Trap-1/HOMIE-Teleop-Hardware/README.md

# <center> HOMIE: Humanoid Loco-Manipulation with Isomorphic Exoskeleton Cockpit</center>
