Trap-1/HOMIE-Teleop-Hardware/Geber &  Boom/BOM_Gloves.csv

ID | Name | Designator | Footprint | Quantity | Manufacturer Part | Supplier Part | Price | Pins | 3DModel | link
1 | 104 | C8,C15,C16,C1,C2,C3,C4,C6,C7 | C0603 | 9 |  |  |  | 2 | C0603_L1.6-W0.8-H0.8 | https://item.szlcsc.com/362304.html
2 | 106 | C9,C5 | C0603 | 2 |  |  |  | 2 | C0603_L1.6-W0.8-H0.8 | https://item.szlcsc.com/362304.html
3 | 1k | R2,R5,R18 | R0603 | 3 |  |  |  | 2 | R0603 | https://www.mouser.in/datasheet/2/447/PYu_RT_1_to_0_01_RoHS_L_11-1669912.pdf
4 | AMS1117-3.3V | U2 | SOT-223-4_L6.5-W3.5-P2.30-LS7.0-BR | 1 | AMS1117-3.3V | C2688239 | 0.397 | 4 | SOT-223-4P_L6.5-W3.5-H1.6-LS7.0-P2.30 | https://item.szlcsc.com/84517.html
5 | 47UF/10V | U4 | C1206 | 1 | 47uF/10V | C9900008467 |  | 2 | C1206_L3.2-W1.6-H1.3 | https://atta.szlcsc.comnull
6 | XH-4AW_C2908613 | CN2 | CONN-TH_XH-4AW | 1 | XH-4AW | C2908613 | 0.1565 | 4 | CONN-TH_XH-4AW | https://atta.szlcsc.com/upload/public/pdf/source/20211021/ACA2D54D99493880102FCACAC8DAABA8.pdf
7 | LED0603-R | LED1,LED2,LED9 | LED0603-R-RD | 3 | LED0603-R | C9900005326 |  | 2 | LED0603-R-RD | https://lcsc.com/product-detail/Light-Emitting-Diodes-LED_Hubei-KENTO-Elec-0603-Green_C12624.html
8 | 10k | R1,R11,R15 | R0603 | 3 |  |  |  | 2 | R0603 | https://www.mouser.in/datasheet/2/447/PYu_RT_1_to_0_01_RoHS_L_11-1669912.pdf
9 | STM32F103C8T6 | U1 | LQFP-48_L7.0-W7.0-P0.50-LS9.0-BL | 1 | STM32F103C8T6 | C8734 | 7.45 | 48 | LQFP-48_L7.0-W7.0-H1.4-LS9.0-P0.50 | https://atta.szlcsc.com/upload/public/pdf/source/20190808/C411336_D1D2DF7683029D856BA010BA7A5BF7EA.pdf
10 | CD74HC4067SM96 | U3 | SSOP-24_L8.1-W5.3-P0.65-LS7.8-BL | 1 | CD74HC4067SM96 | C98457 | 3.4 | 24 | SSOP-24_L8.2-W5.3-H1.8-LS7.8-P0.65 | https://item.szlcsc.com/255758.html
11 | WAFER-PH2.0-3PZZ-R62 | U5,U6,U8,U10,U11,U12,U13,U14,U15,U16,U17,U18,U19,U20,U21 | CONN-TH_4P-P2.00_WAFER-PH2.0-3PZZ-R62 | 15 | WAFER-PH2.0-3PZZ-R62 | C22390428 | 0.1784 | 3 | CONN-TH_3P-P2.00_WAFER-PH2.0-3PZZ-R62 | https://atta.szlcsc.com/upload/public/pdf/source/20240428/DCE8F361ED40A64D6B78F768F58AF30D.pdf
12 | CH340E | U7 | MSOP-10_L3.0-W3.0-P0.50-LS5.0-BL | 1 | CH340E | C99652 | 4.19 | 10 | MSOP-10_L3.0-W3.0-H1.1-LS5.0-P0.50 | https://item.szlcsc.com/221388.html
13 | TPS645-5NC60 | U9,U22 | SW-SMD_4P-L6.0-W6.0-P4.50-LS9.2 | 2 | TPS645-5NC60 | C19191552 | 0.2853 | 4 | SW-SMD_4P-L6.0-W6.0-P4.50-LS9.2 | https://item.szlcsc.com/617126.html
14 | UX-150-ARG4 | USB1 | MICRO-USB-TH_UX-150-ARG4 | 1 | UX-150-ARG4 | C720612 | 0.6217 | 9 | MICRO-USB-TH_UX-150-ARG4 | https://item.szlcsc.com/763619.html
15 | 8MHz | X1 | OSC-SMD_3P-L3.2-W1.3-P1.2-L | 1 | CSTCE8M00G52-R0 | C22549 | 1.4275 | 3 | OSC-SMD_3P-L3.2-W1.3-H0.8-P1.2 | https://item.szlcsc.com/23275.html
