Trap-1/HOMIE-Teleop-Hardware/Geber &  Boom/BOM_Pedal.csv

ID | Name | Designator | Footprint | Quantity | Manufacturer Part | Supplier Part | Price | Pins | 3DModel | link
1 | ZX-XH2.54-2PZZ | CN7,CN8,CN1 | CONN-TH_2P-P2.50_HX25003-2A | 3 | ZX-XH2.54-2PZZ | C7429632 | 0.0377 | 2 | CONN-TH_2P-P2.50_HX25003-2A | https://item.szlcsc.com/442531.html
2 | 104 | C2,C3,C16,C1,C4,C7,C8,C11,C15 | C0603 | 9 |  |  |  | 2 | C0603_L1.6-W0.8-H0.8 | https://item.szlcsc.com/362304.html
3 | 10k | R15,R17,R19,R20,R16,R11 | R0603 | 6 |  |  |  | 2 | R0603 | https://www.mouser.in/datasheet/2/447/PYu_RT_1_to_0_01_RoHS_L_11-1669912.pdf
4 | XH-4AW_C2908613 | CN2 | CONN-TH_XH-4AW | 1 | XH-4AW | C2908613 | 0.1565 | 4 | CONN-TH_XH-4AW | https://atta.szlcsc.com/upload/public/pdf/source/20211021/ACA2D54D99493880102FCACAC8DAABA8.pdf
5 | XH-3AW_C2908612 | CN3,CN4,CN5,CN6 | CONN-TH_3P-P2.54_HCTL_XH-3AW | 4 | XH-3AW | C2908612 | 0.1187 | 3 | CONN-TH_3P-P2.54_HCTL_XH-3AW | https://atta.szlcsc.com/upload/public/pdf/source/20211021/ACA2D54D99493880102FCACAC8DAABA8.pdf
6 | OLED | HDR1 | HDR-TH_4P-P2.54-V-M | 1 |  | C9900026893 |  | 4 | HDR-TH_4P-P2.54-M-LI-1X4P | https://item.szlcsc.com/502959.html
7 | Header-Male-2.54_2x3 | J1 | HDR-TH_6P-P2.54-V-M-R2-C3-S2.54-1 | 1 | 2.54-2*3P针 | C65114 | 0.1969 | 6 | HDR2.54-M-LI-2x3P | https://lcsc.com/product-detail/Female-Header_Made-in-China-Made-in-China-Made-in-China-Made-in-Cina-2-54mm-2x3-Female-header-Bagged-RoHS_C47552.html
8 | LED0603-R | LED1,LED2,LED9 | LED0603-R-RD | 3 | LED0603-R | C9900005326 |  | 2 | LED0603-R-RD | https://lcsc.com/product-detail/Light-Emitting-Diodes-LED_Hubei-KENTO-Elec-0603-Green_C12624.html
9 | 2N3904_C2874602 | Q1 | TO-92-3_L4.6-W3.6-P1.30-L_2N3904 | 1 | 2N3904 | C2874602 | 0.0733 | 3 | TO-92-3_L4.6-W3.6-P1.30-L_2N3904 | https://atta.szlcsc.com/upload/public/pdf/source/20211216/4B1D0208BBB09785024BED84C152EFE5.pdf
10 | 1k | R2,R5,R18 | R0603 | 3 |  |  |  | 2 | R0603 | https://www.mouser.in/datasheet/2/447/PYu_RT_1_to_0_01_RoHS_L_11-1669912.pdf
11 | STM32F103C8T6 | U1 | LQFP-48_L7.0-W7.0-P0.50-LS9.0-BL | 1 | STM32F103C8T6 | C8734 | 7.45 | 48 | LQFP-48_L7.0-W7.0-H1.4-LS9.0-P0.50 | https://atta.szlcsc.com/upload/public/pdf/source/20190808/C411336_D1D2DF7683029D856BA010BA7A5BF7EA.pdf
12 | CH340E | U7 | MSOP-10_L3.0-W3.0-P0.50-LS5.0-BL | 1 | CH340E | C99652 | 4.19 | 10 | MSOP-10_L3.0-W3.0-H1.1-LS5.0-P0.50 | https://item.szlcsc.com/221388.html
13 | TPS645-5NC60 | U9,U10 | SW-SMD_4P-L6.0-W6.0-P4.50-LS9.2 | 2 | TPS645-5NC60 | C19191552 | 0.2853 | 4 | SW-SMD_4P-L6.0-W6.0-P4.50-LS9.2 | https://item.szlcsc.com/617126.html
14 | UX-150-ARG4 | USB1 | MICRO-USB-TH_UX-150-ARG4 | 1 | UX-150-ARG4 | C720612 | 0.6217 | 9 | MICRO-USB-TH_UX-150-ARG4 | https://item.szlcsc.com/763619.html
15 | 8MHz | X1 | OSC-SMD_3P-L3.2-W1.3-P1.2-L | 1 | CSTCE8M00G52-R0 | C22549 | 1.4275 | 3 | OSC-SMD_3P-L3.2-W1.3-H0.8-P1.2 | https://item.szlcsc.com/23275.html
16 | 106 | C5,C9 | C0603 | 2 |  |  |  | 2 | C0603_L1.6-W0.8-H0.8 | https://item.szlcsc.com/362304.html
17 | AMS1117-3.3V | U2 | SOT-223-4_L6.5-W3.5-P2.30-LS7.0-BR | 1 | AMS1117-3.3V | C2688239 | 0.397 | 4 | SOT-223-4P_L6.5-W3.5-H1.6-LS7.0-P2.30 | https://item.szlcsc.com/84517.html
18 | 47UF/10V | U4 | C1206 | 1 | 47uF/10V | C9900008467 |  | 2 | C1206_L3.2-W1.6-H1.3 | https://atta.szlcsc.comnull
