Trap-1/HOMIE-Teleop-Hardware/Geber &  Boom/BOM_Hall-sensor.csv

ID | Name | Designator | Footprint | Quantity | Manufacturer Part | Supplier Part | Price | Pins | 3DModel | link
1 | WAFER-PH2.0-3PZZ-R62 | U3 | CONN-TH_4P-P2.00_WAFER-PH2.0-3PZZ-R62 | 1 | WAFER-PH2.0-3PZZ-R62 | C22390428 | 0.1784 | 3 | CONN-TH_3P-P2.00_WAFER-PH2.0-3PZZ-R62 | https://atta.szlcsc.com/upload/public/pdf/source/20240428/DCE8F361ED40A64D6B78F768F58AF30D.pdf
2 | MS49E | U1 | TO-92S-3_L4.1-W1.7-P1.27-L | 1 | MS49E | C1509062 | 3 | 3 | TO-92S-3_L4.1-W1.7-H6.5-P1.27-L | https://item.szlcsc.com/product/jpg_256473_0.html
