Trap-1/HOMIE-Teleop-Hardware/3D printed models/Foot Pedal/Switch pedal/Whole switch pedal.step

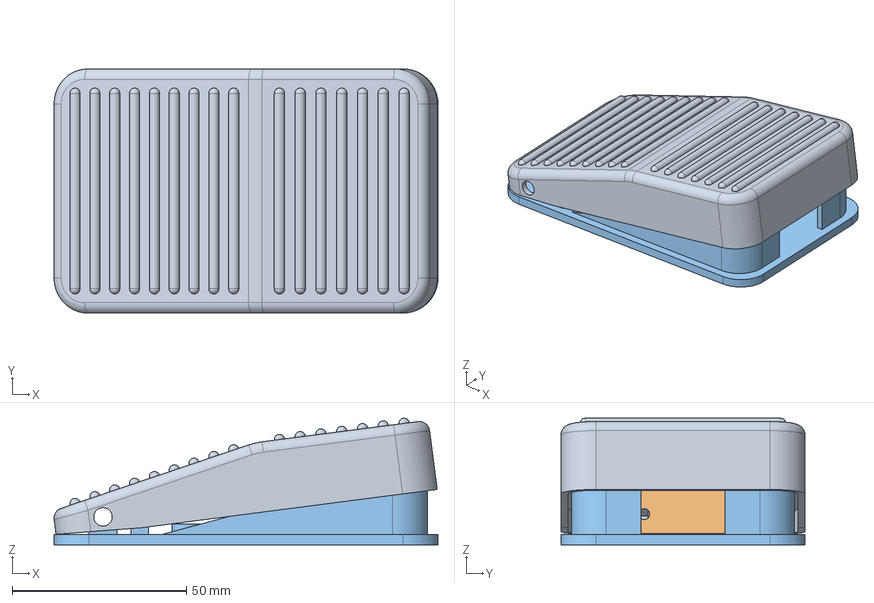
[picture p1: CAD file, 2025-02-11]
3D printed models/Foot Pedal/Switch pedal/Whole switch pedal.step
110.0 x 70.0 x 36.3 mm
上板
连接件2
底板
