Trap-1/HOMIE-Teleop-Hardware/3D printed models/Foot Pedal/Small pedal/Whole small pedal.step

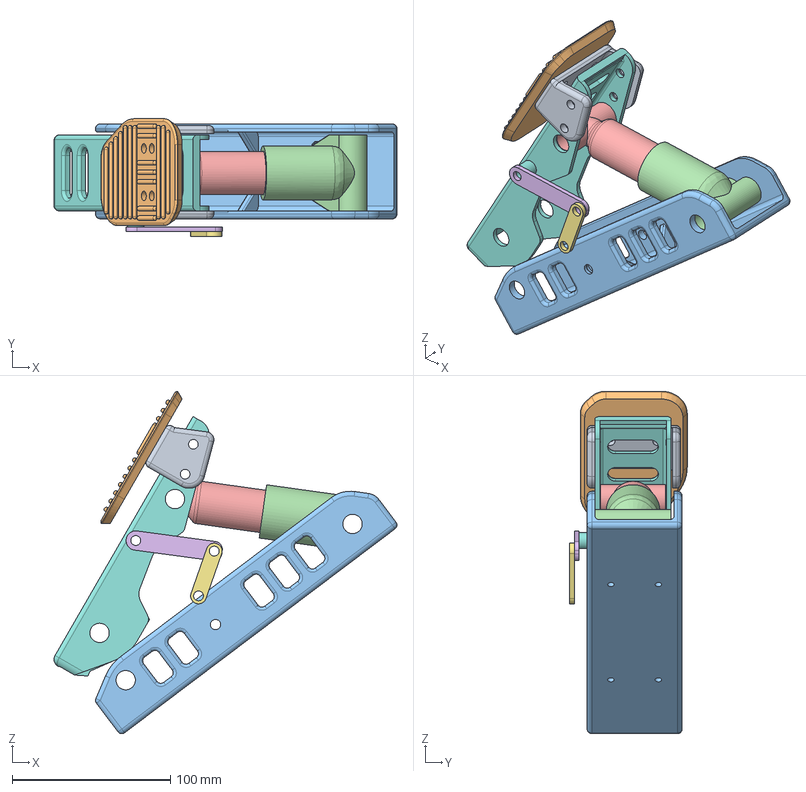
[picture p2: CAD file, 2025-02-11]
3D printed models/Foot Pedal/Small pedal/Whole small pedal.step
216.7 x 74.3 x 216.4 mm
零部件2
零部件3
零部件4
零部件5
零部件6
零部件7
零部件8
零部件9
