Trap-1/HOMIE-Teleop-Hardware/3D printed models/Exoskeleton/Fourier_GR-1/ARM_LEFT/ARM_6.step

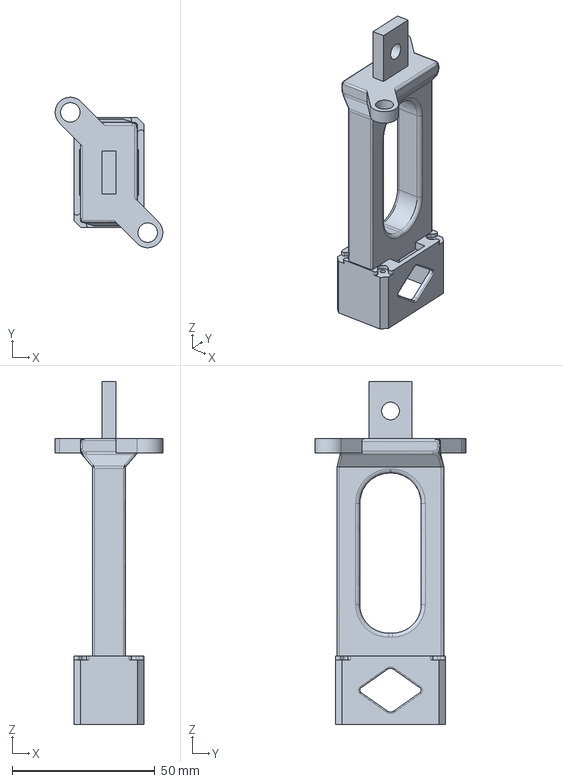
[picture p3: CAD file, 2025-02-11]
3D printed models/Exoskeleton/Fourier_GR-1/ARM_LEFT/ARM_6.step
37.7 x 52.7 x 120.0 mm
