Trap-1/HOMIE-Teleop-Hardware/3D printed models/Exoskeleton/Fourier_GR-1/ARM_RIGHT/ARM_2.step

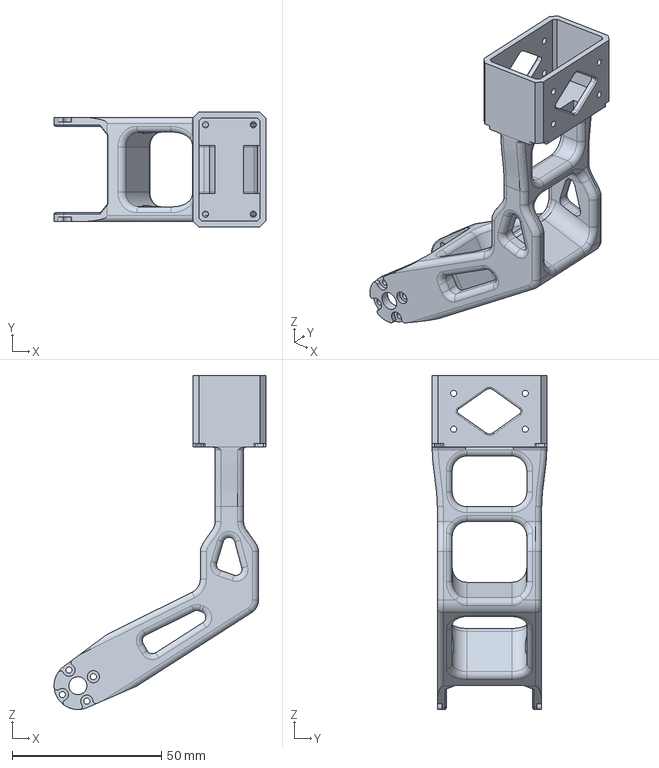
[picture p4: CAD file, 2025-02-11]
3D printed models/Exoskeleton/Fourier_GR-1/ARM_RIGHT/ARM_2.step
71.0 x 38.5 x 112.0 mm
