Trap-1/HOMIE-Teleop-Hardware/3D printed models/Exoskeleton/Fourier_GR-1/BACK/BACK-5(RIGHT).step

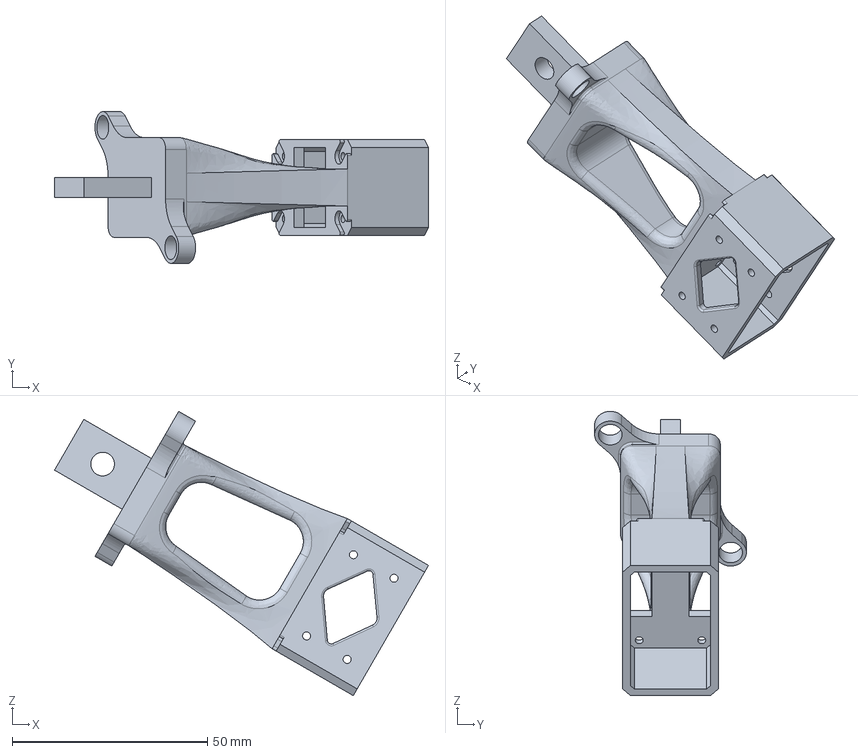
[picture p5: CAD file, 2025-02-11]
3D printed models/Exoskeleton/Fourier_GR-1/BACK/BACK-5(RIGHT).step
95.7 x 38.9 x 72.8 mm
