Trap-1/HOMIE-Teleop-Hardware/3D printed models/Exoskeleton/Fourier_GR-1/WRIST_LINK/WRIST_LINK_RIGHT.step

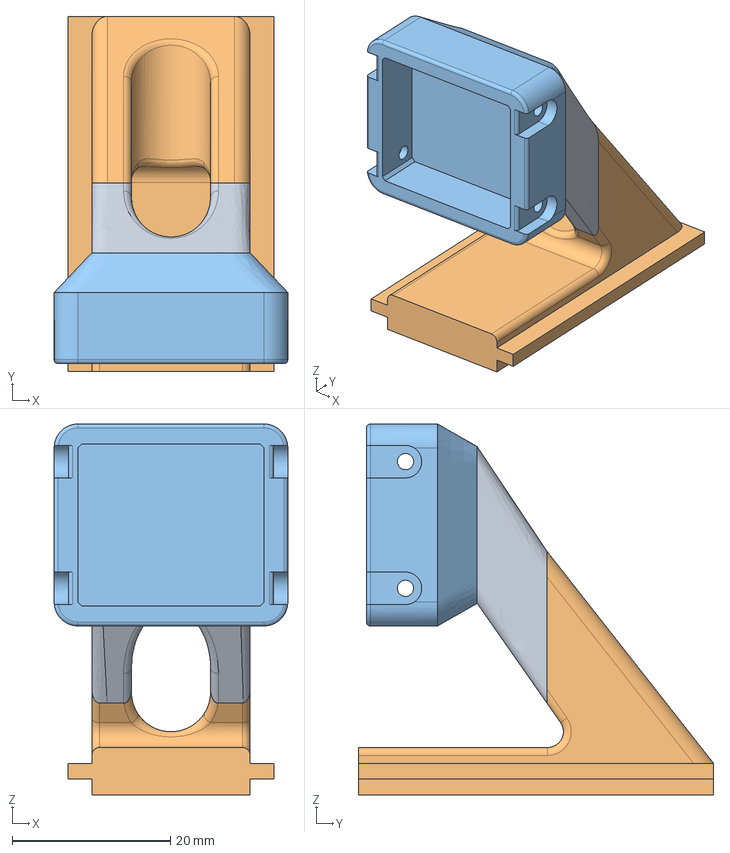
[picture p6: CAD file, 2025-02-11]
3D printed models/Exoskeleton/Fourier_GR-1/WRIST_LINK/WRIST_LINK_RIGHT.step
29.5 x 44.9 x 46.8 mm
手部连接2 (2)(镜像)(镜像)
手部连接1(镜像)(镜像)
外骨骼_基础2 v1 (1)(镜像)
