Trap-1/HOMIE-Teleop-Hardware/3D printed models/Exoskeleton/Unitree_G1/ARM_LEFT/ARM_5.step

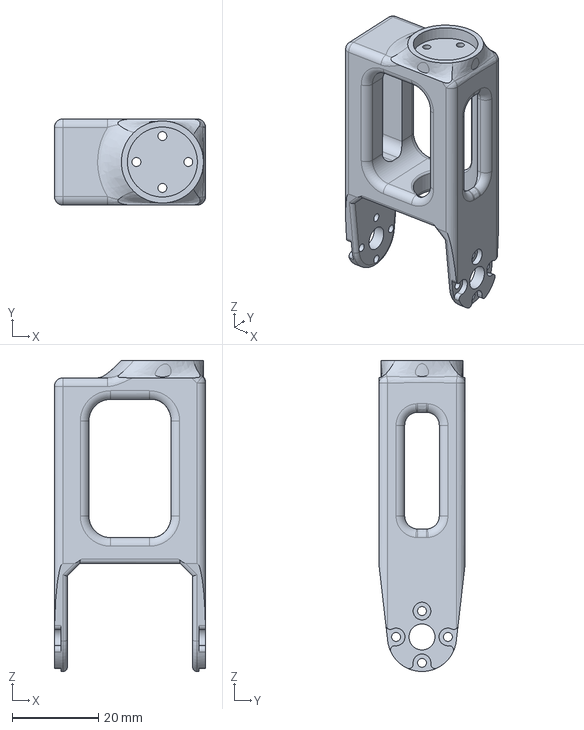
[picture p7: CAD file, 2025-02-11]
3D printed models/Exoskeleton/Unitree_G1/ARM_LEFT/ARM_5.step
35.0 x 20.0 x 72.0 mm
