Trap-1/HOMIE-Teleop-Hardware/3D printed models/Exoskeleton/Unitree_G1/BACK/BACK_3.step

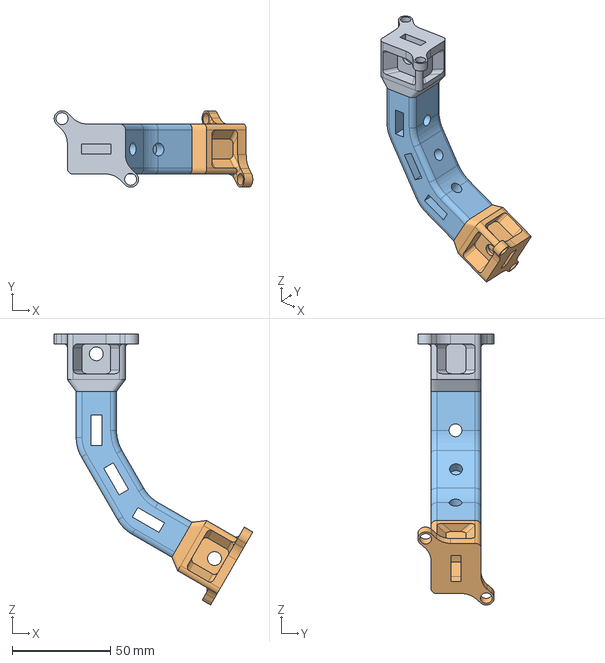
[picture p8: CAD file, 2025-02-11]
3D printed models/Exoskeleton/Unitree_G1/BACK/BACK_3.step
100.9 x 38.9 x 137.7 mm
