Trap-1/HOMIE-Teleop-Hardware/3D printed models/Exoskeleton/Unitree_G1/WRIST_LINK/WRIST_LINK_LEFT.step

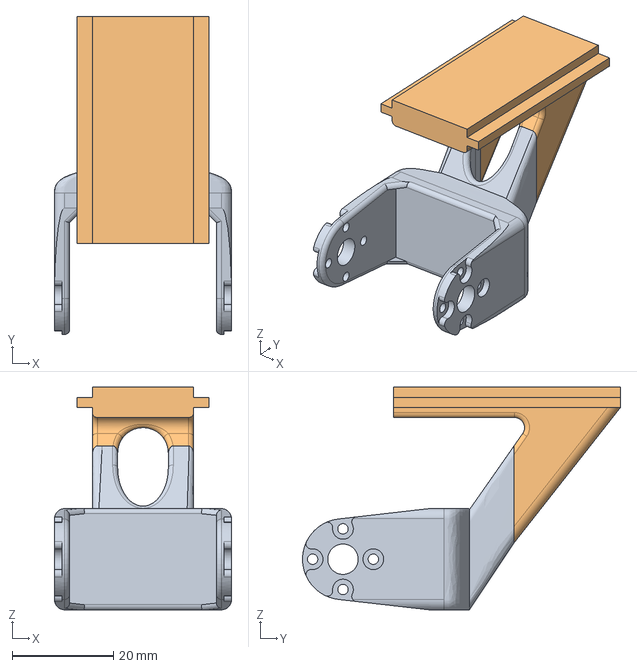
[picture p9: CAD file, 2025-02-11]
3D printed models/Exoskeleton/Unitree_G1/WRIST_LINK/WRIST_LINK_LEFT.step
35.0 x 62.9 x 44.0 mm
手部连接2 (2)(镜像)
手部连接1(镜像)
