Trap-1/HOMIE-Teleop-Hardware/3D printed models/Foot Pedal/Base plate/Baseplate.step

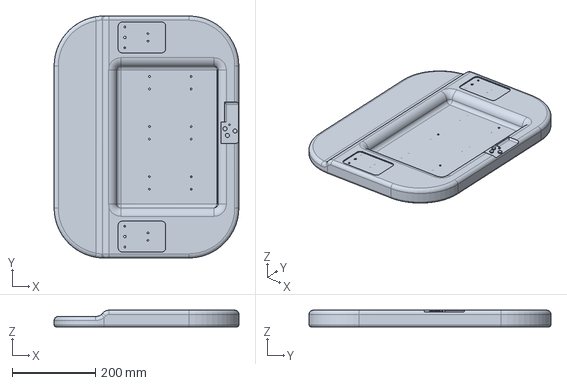
[picture p10: CAD file, 2025-02-11]
3D printed models/Foot Pedal/Base plate/Baseplate.step
443.0 x 580.0 x 40.0 mm
