Trap-1/HOMIE-Teleop-Hardware/3D printed models/Gloves/Left glove/1 Thumb/Thumb_4(special).step

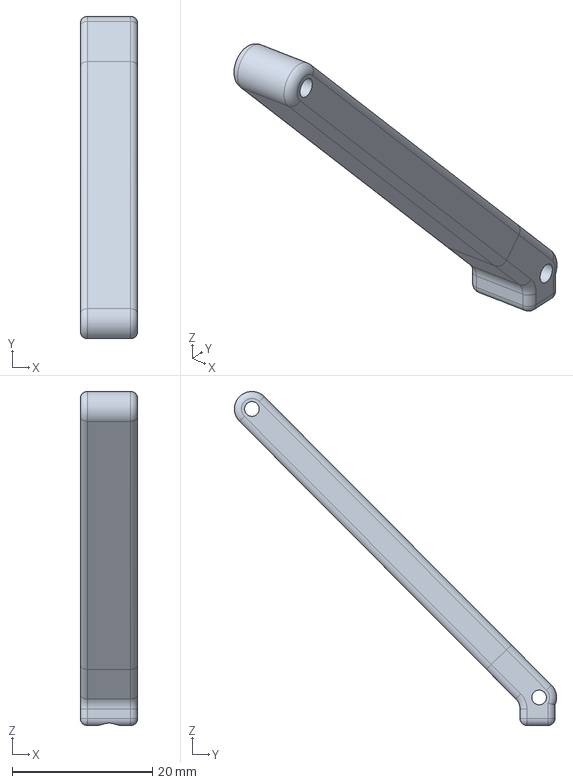
[picture p12: CAD file, 2025-02-11]
3D printed models/Gloves/Left glove/1 Thumb/Thumb_4(special).step
8.21 x 46.0 x 47.7 mm
