Trap-1/HOMIE-Teleop-Hardware/3D printed models/Gloves/Left glove/2 Index finger/Index finger_6.step

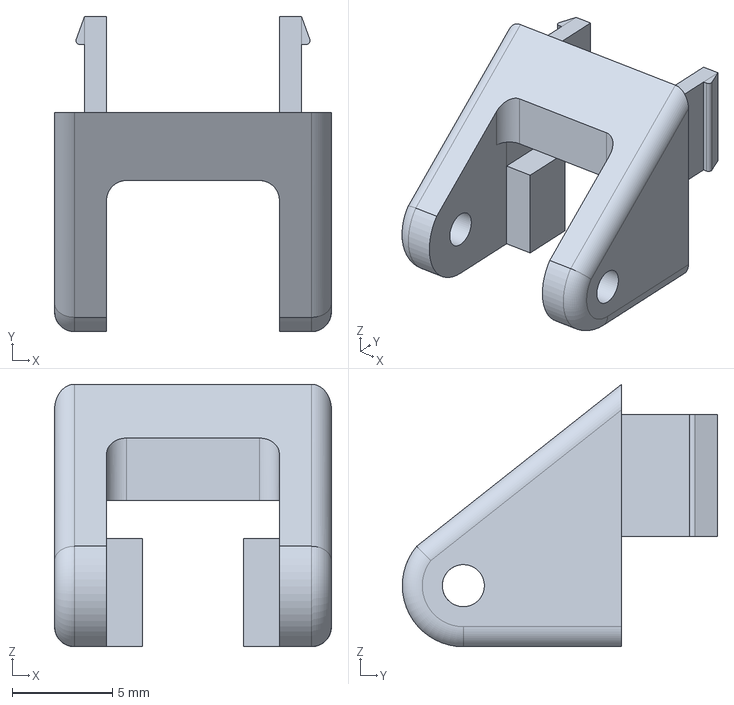
[picture p13: CAD file, 2025-02-11]
3D printed models/Gloves/Left glove/2 Index finger/Index finger_6.step
13.8 x 15.8 x 13.1 mm
