Trap-1/HOMIE-Teleop-Hardware/3D printed models/Gloves/Left glove/3 Middle finger/Middle finger_7.step

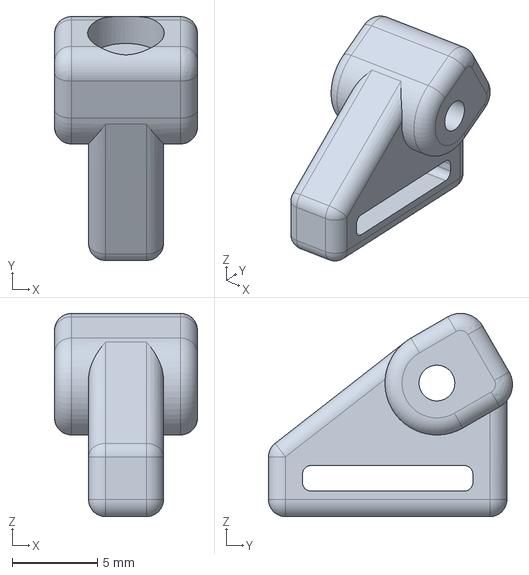
[picture p14: CAD file, 2025-02-11]
3D printed models/Gloves/Left glove/3 Middle finger/Middle finger_7.step
8.40 x 14.3 x 11.9 mm
