Trap-1/HOMIE-Teleop-Hardware/3D printed models/Gloves/Left glove/4 Ring finger/Ring finger_4.step

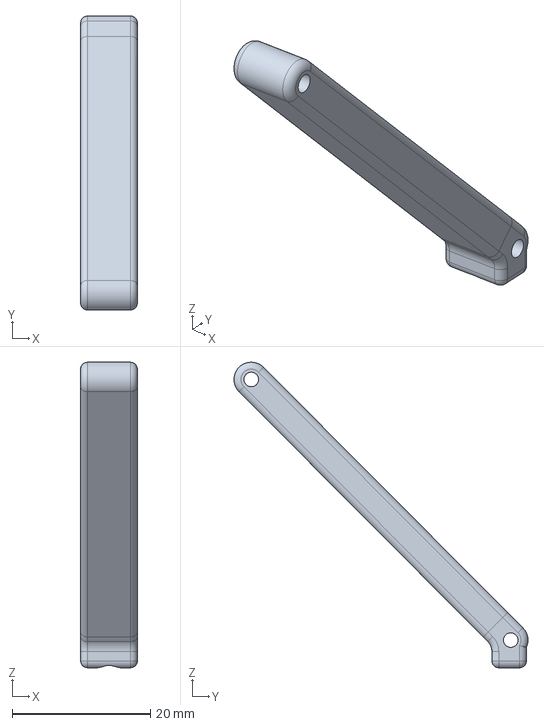
[picture p15: CAD file, 2025-02-11]
3D printed models/Gloves/Left glove/4 Ring finger/Ring finger_4.step
8.21 x 42.5 x 44.2 mm
