Trap-1/HOMIE-Teleop-Hardware/3D printed models/Gloves/Left glove/6 Palm/Palm_2.step

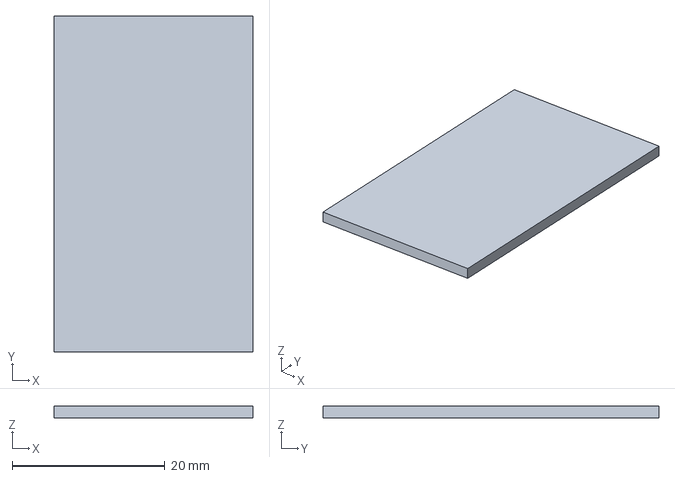
[picture p16: CAD file, 2025-02-11]
3D printed models/Gloves/Left glove/6 Palm/Palm_2.step
26.0 x 44.0 x 1.60 mm
