Trap-1/HOMIE-Teleop-Hardware/3D printed models/Gloves/Right glove/2 Index finger/Index finger_2.step

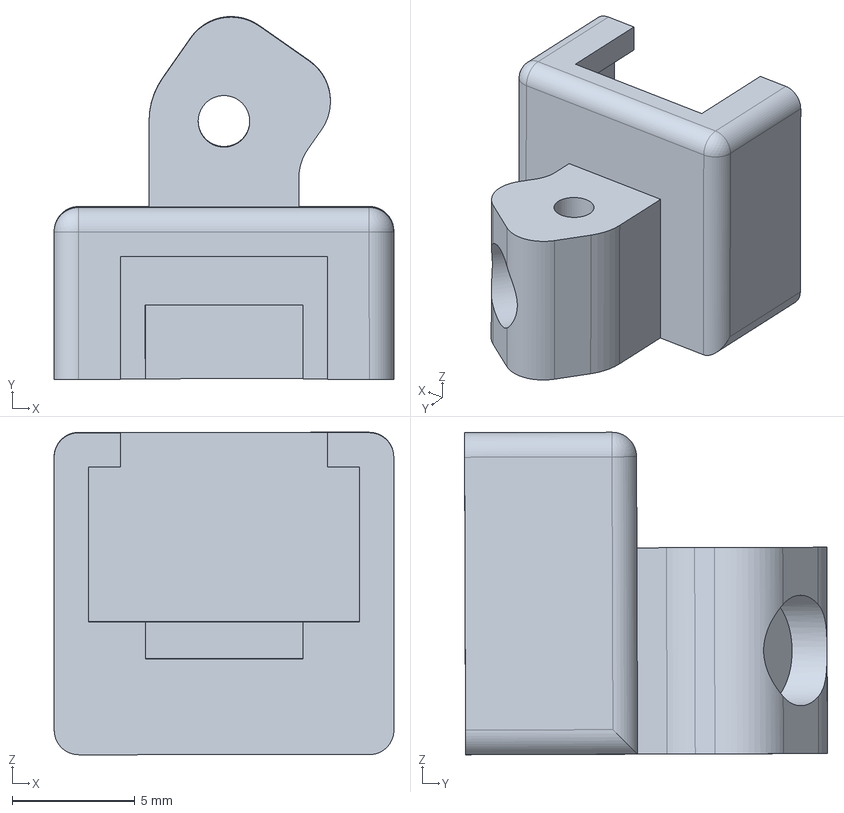
[picture p17: CAD file, 2025-02-11]
3D printed models/Gloves/Right glove/2 Index finger/Index finger_2.step
13.8 x 14.8 x 13.1 mm
