Trap-1/HOMIE-Teleop-Hardware/3D printed models/Gloves/Right glove/3 Middle finger/Middle finger_5.step

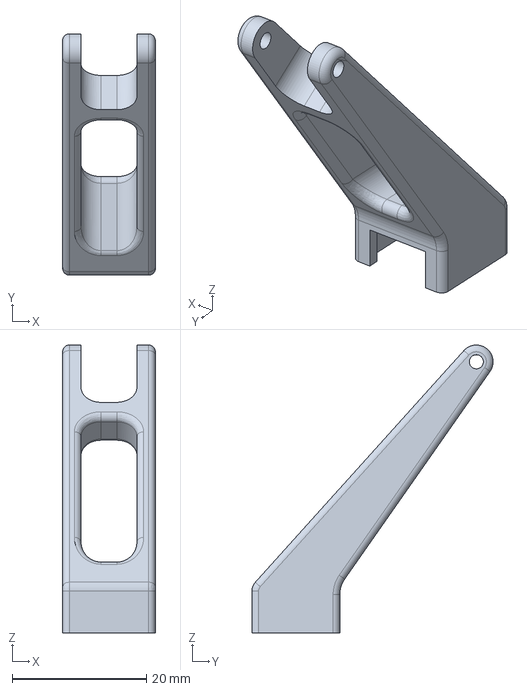
[picture p18: CAD file, 2025-02-11]
3D printed models/Gloves/Right glove/3 Middle finger/Middle finger_5.step
13.8 x 36.0 x 42.9 mm
