Trap-1/HOMIE-Teleop-Hardware/3D printed models/Gloves/Right glove/6 Palm/Palm_1.step

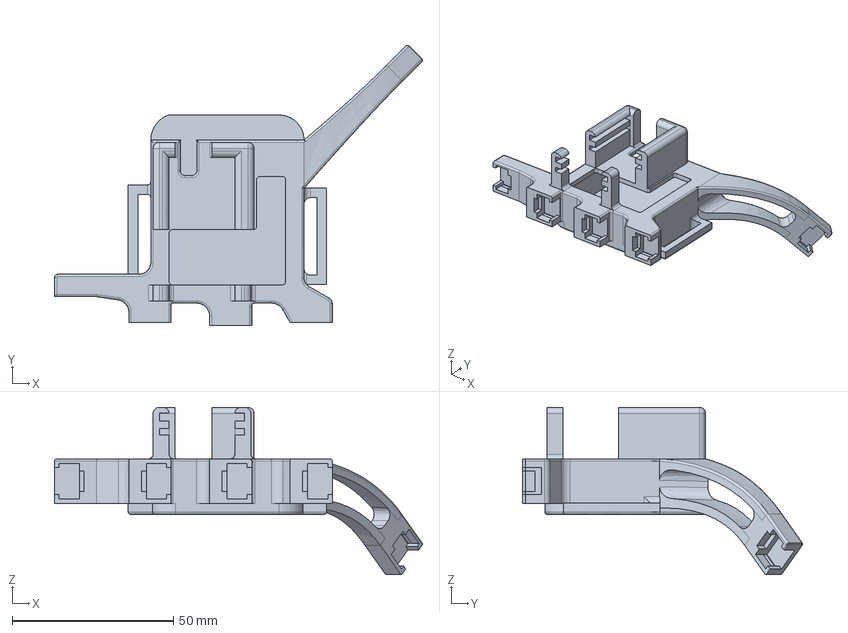
[picture p19: CAD file, 2025-02-11]
3D printed models/Gloves/Right glove/6 Palm/Palm_1.step
114.2 x 87.0 x 52.0 mm
