Trap-1/HOMIE-Teleop-Hardware/3D printed models/Imitation Learning/Head_camera_D455/Head_camera_D455.step

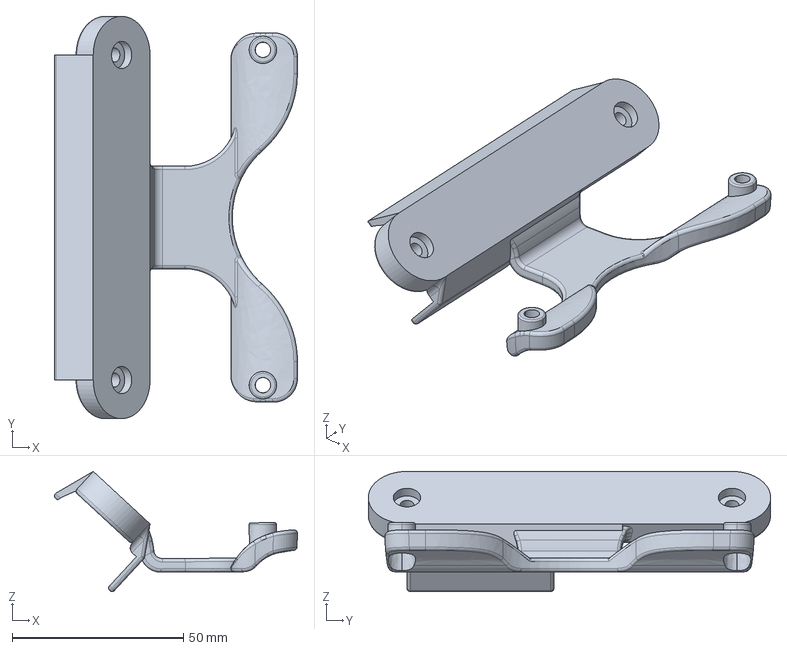
[picture p20: CAD file, 2025-02-12]
3D printed models/Imitation Learning/Head_camera_D455/Head_camera_D455.step
71.0 x 117.6 x 35.1 mm
