Trap-1/HOMIE-Teleop-Hardware/3D printed models/Imitation Learning/Wrist_camera_D435/Right_Wrist_camera_D435.step

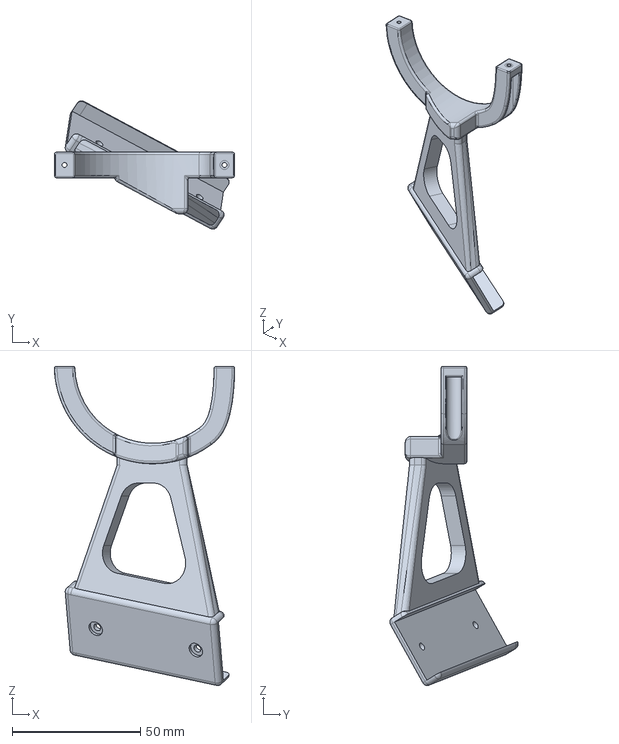
[picture p21: CAD file, 2025-02-12]
3D printed models/Imitation Learning/Wrist_camera_D435/Right_Wrist_camera_D435.step
70.2 x 50.0 x 124.2 mm
