Trap-1/HOMIE-Teleop-Hardware/3D printed models/Exoskeleton/Fourier_GR-1/ARM_RIGHT/ARM_8.step

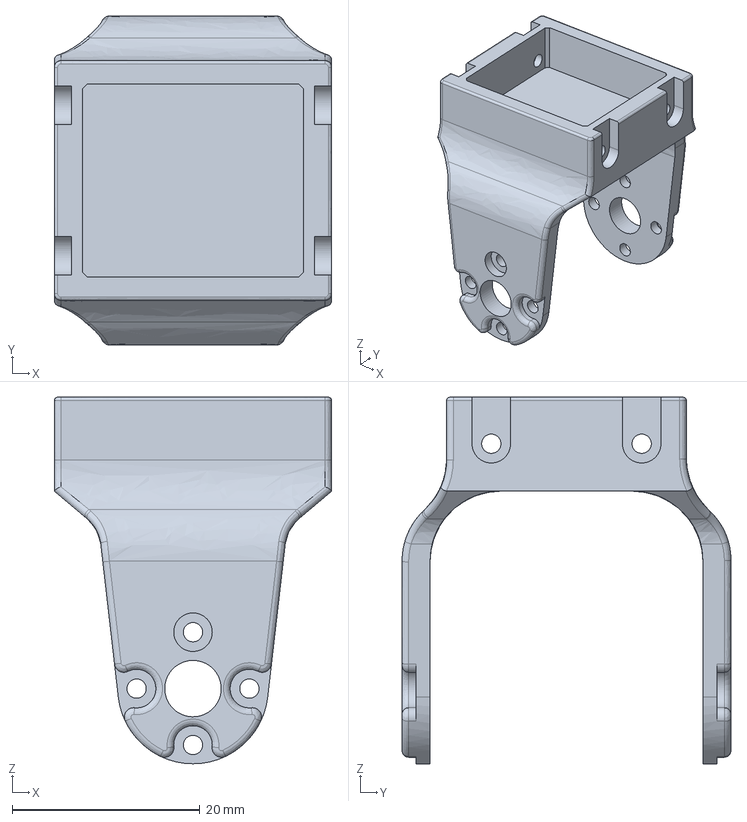
[picture p23: CAD file, 2025-02-11]
3D printed models/Exoskeleton/Fourier_GR-1/ARM_RIGHT/ARM_8.step
29.5 x 35.0 x 39.0 mm
