Trap-1/HOMIE-Teleop-Hardware/3D printed models/Exoskeleton/Fourier_GR-1/BACK/BACK_2.step

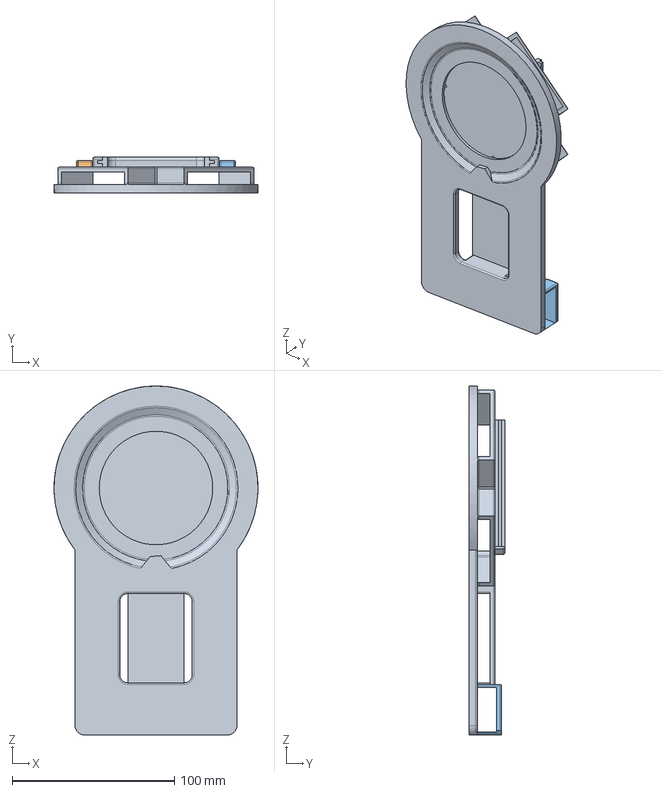
[picture p24: CAD file, 2025-02-11]
3D printed models/Exoskeleton/Fourier_GR-1/BACK/BACK_2.step
125.7 x 22.0 x 215.2 mm
