Trap-1/HOMIE-Teleop-Hardware/3D printed models/Exoskeleton/Unitree_G1/ARM_LEFT/ARM_2.step

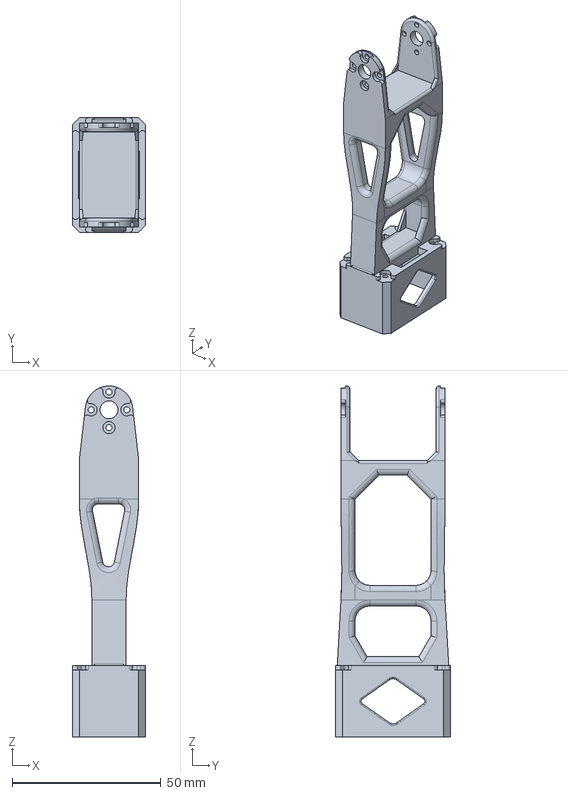
[picture p25: CAD file, 2025-02-11]
3D printed models/Exoskeleton/Unitree_G1/ARM_LEFT/ARM_2.step
24.5 x 38.5 x 118.0 mm
