Trap-1/HOMIE-Teleop-Hardware/3D printed models/Exoskeleton/Unitree_G1/ARM_RIGHT/ARM_1.step

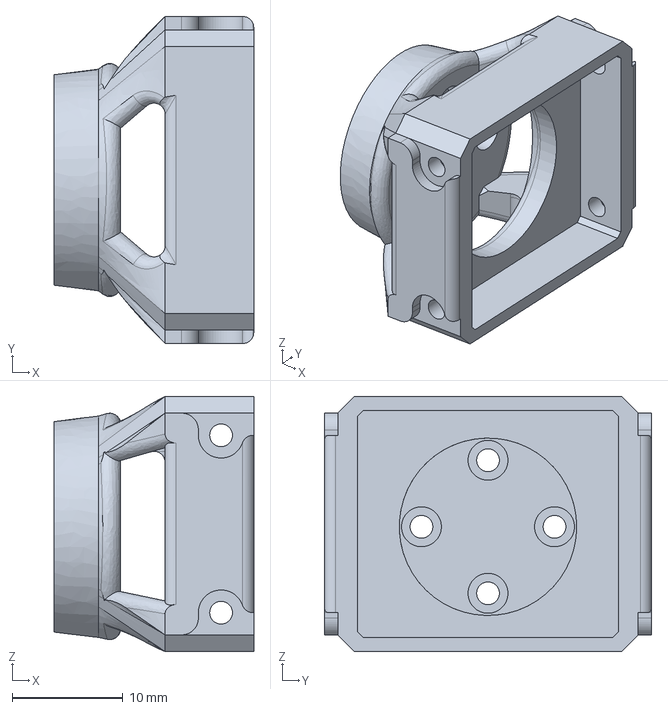
[picture p26: CAD file, 2025-02-11]
3D printed models/Exoskeleton/Unitree_G1/ARM_RIGHT/ARM_1.step
18.0 x 29.5 x 23.0 mm
