Trap-1/HOMIE-Teleop-Hardware/3D printed models/Exoskeleton/Unitree_G1/BACK/BACK_4(LEFT).step

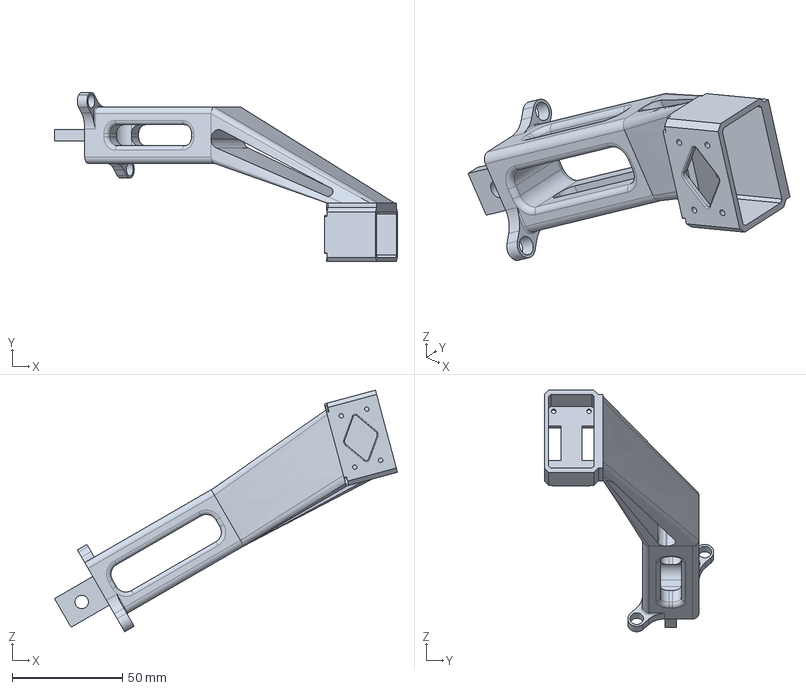
[picture p27: CAD file, 2025-02-11]
3D printed models/Exoskeleton/Unitree_G1/BACK/BACK_4(LEFT).step
155.3 x 76.7 x 109.4 mm
