Trap-1/HOMIE-Teleop-Hardware/3D printed models/Foot Pedal/Small pedal/Small pedal_1.step

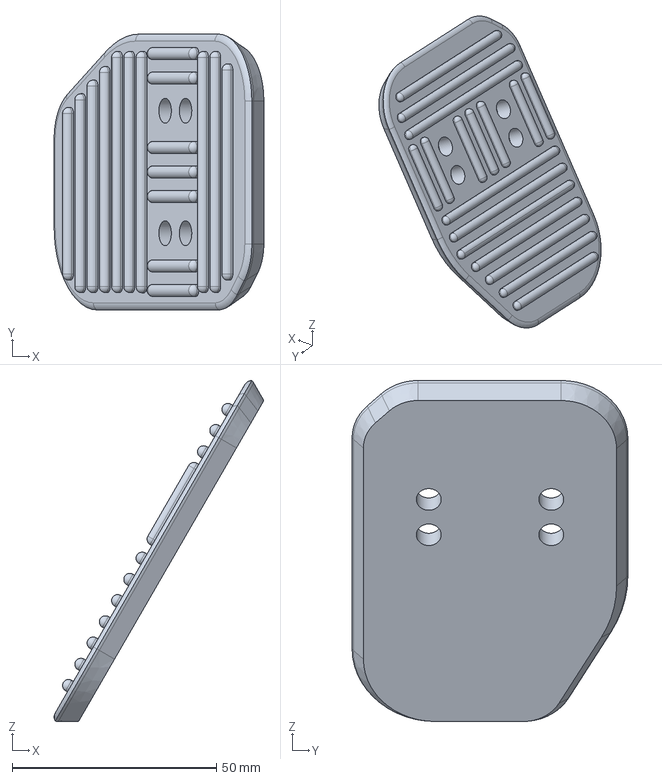
[picture p28: CAD file, 2025-02-11]
3D printed models/Foot Pedal/Small pedal/Small pedal_1.step
51.4 x 67.6 x 83.5 mm
