Trap-1/HOMIE-Teleop-Hardware/3D printed models/Foot Pedal/Switch pedal/Switch pedal_2.step

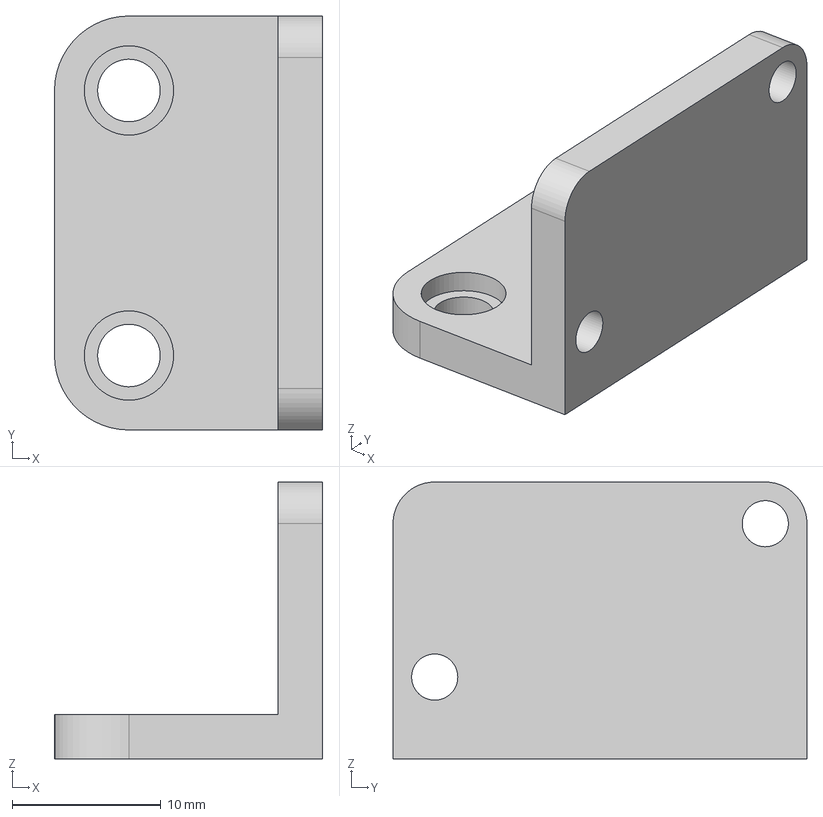
[picture p29: CAD file, 2025-02-11]
3D printed models/Foot Pedal/Switch pedal/Switch pedal_2.step
18.0 x 27.8 x 18.6 mm
