Trap-1/HOMIE-Teleop-Hardware/3D printed models/Gloves/Left glove/3 Middle finger/Middle finger_3.step

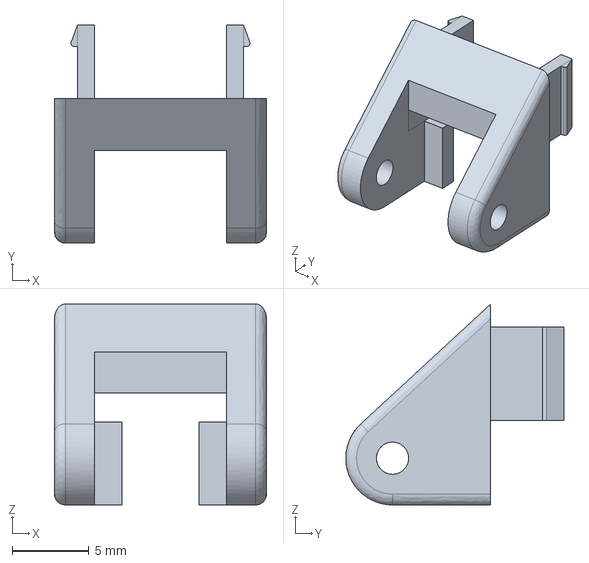
[picture p30: CAD file, 2025-02-11]
3D printed models/Gloves/Left glove/3 Middle finger/Middle finger_3.step
13.8 x 14.3 x 13.1 mm
