Trap-1/HOMIE-Teleop-Hardware/3D printed models/Gloves/Left glove/5 Pinky/Pinky_4(special).step

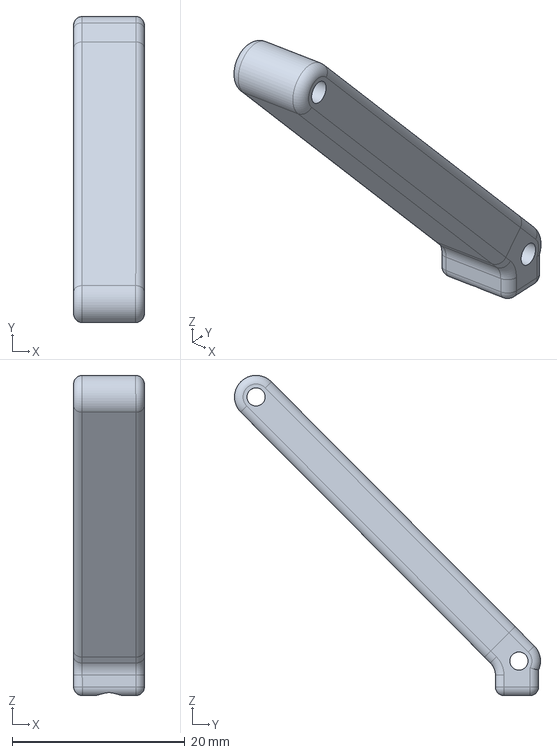
[picture p31: CAD file, 2025-02-11]
3D printed models/Gloves/Left glove/5 Pinky/Pinky_4(special).step
8.21 x 35.4 x 37.1 mm
