Trap-1/HOMIE-Teleop-Hardware/3D printed models/Gloves/Right glove/1 Thumb/Thumb_5(special).step

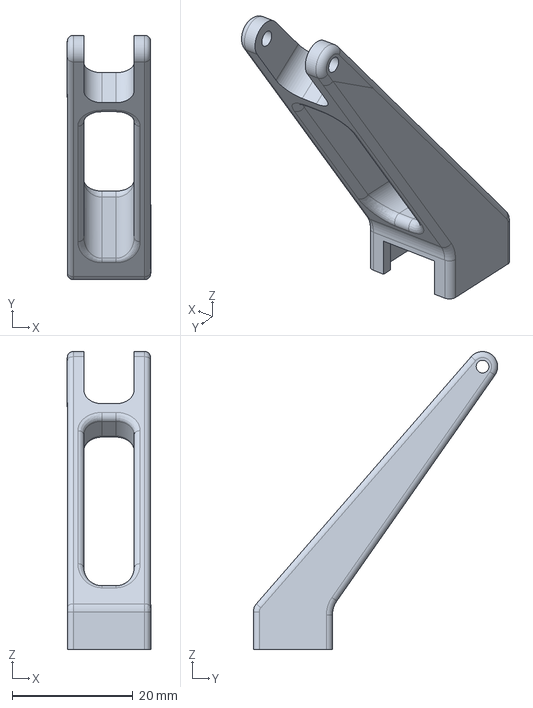
[picture p32: CAD file, 2025-02-11]
3D printed models/Gloves/Right glove/1 Thumb/Thumb_5(special).step
13.8 x 40.5 x 49.4 mm
