Trap-1/HOMIE-Teleop-Hardware/3D printed models/Gloves/Right glove/6 Palm/Palm_3.step

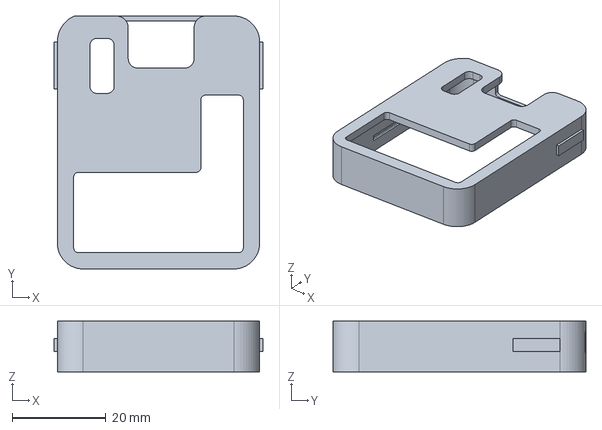
[picture p33: CAD file, 2025-02-11]
3D printed models/Gloves/Right glove/6 Palm/Palm_3.step
44.6 x 54.0 x 10.8 mm
