Trap-1/HOMIE-Teleop-Hardware/3D printed models/Exoskeleton/Unitree_G1/ARM_RIGHT/ARM_4.step

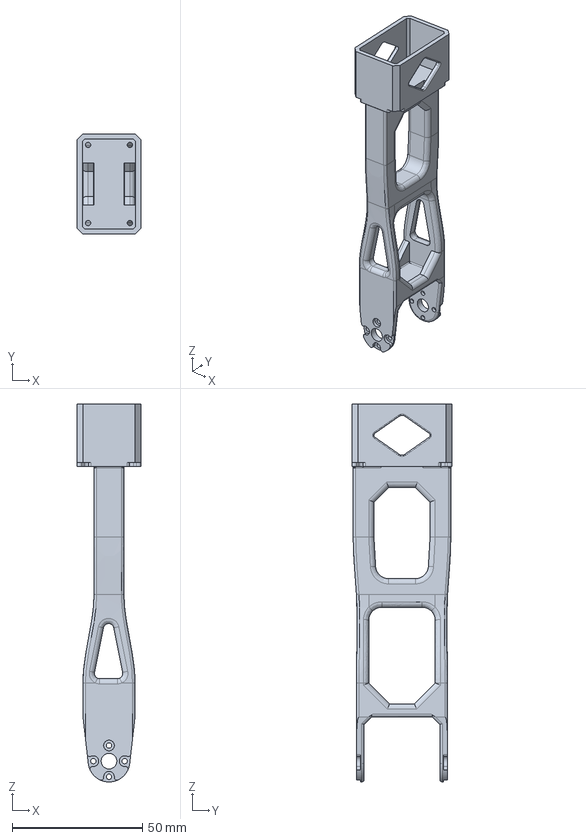
[picture p34: CAD file, 2025-02-11]
3D printed models/Exoskeleton/Unitree_G1/ARM_RIGHT/ARM_4.step
24.5 x 38.5 x 145.0 mm
