Trap-1/HOMIE-Teleop-Hardware/3D printed models/Foot Pedal/Switch pedal/Switch pedal_1.step

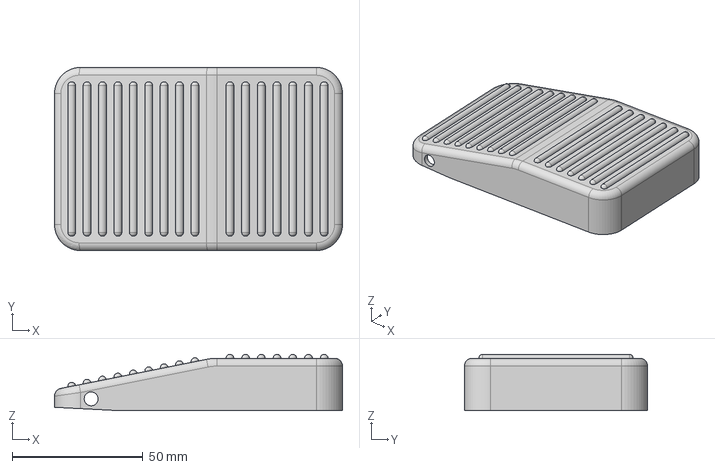
[picture p36: CAD file, 2025-02-11]
3D printed models/Foot Pedal/Switch pedal/Switch pedal_1.step
110.0 x 70.0 x 21.5 mm
