Trap-1/HOMIE-Teleop-Hardware/3D printed models/Gloves/Left glove/5 Pinky/Pinky_5(special).step

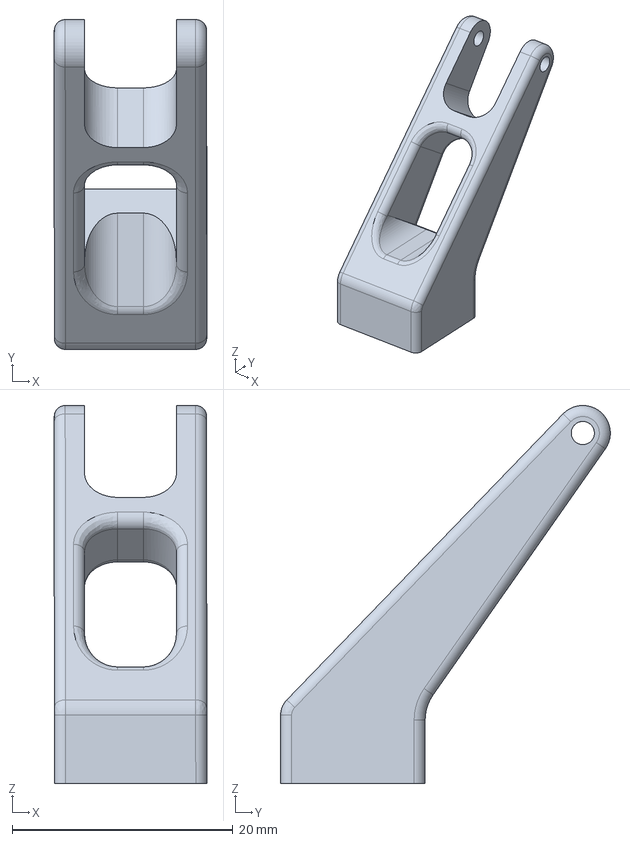
[picture p37: CAD file, 2025-02-11]
3D printed models/Gloves/Left glove/5 Pinky/Pinky_5(special).step
13.8 x 29.9 x 34.3 mm
