Trap-1/HOMIE-Teleop-Hardware/3D printed models/Gloves/Left glove/6 Palm/Palm_4.step

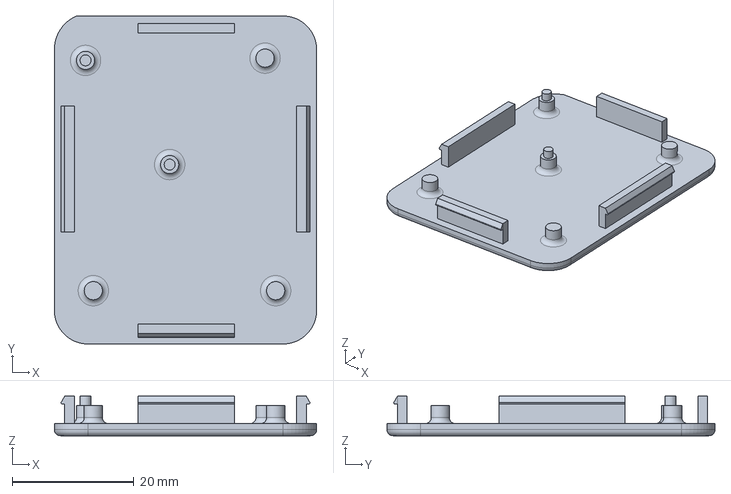
[picture p38: CAD file, 2025-02-11]
3D printed models/Gloves/Left glove/6 Palm/Palm_4.step
43.2 x 54.0 x 6.50 mm
