Trap-1/HOMIE-Teleop-Hardware/3D printed models/Imitation Learning/Wrist_camera_D435/Wrist_loop.step

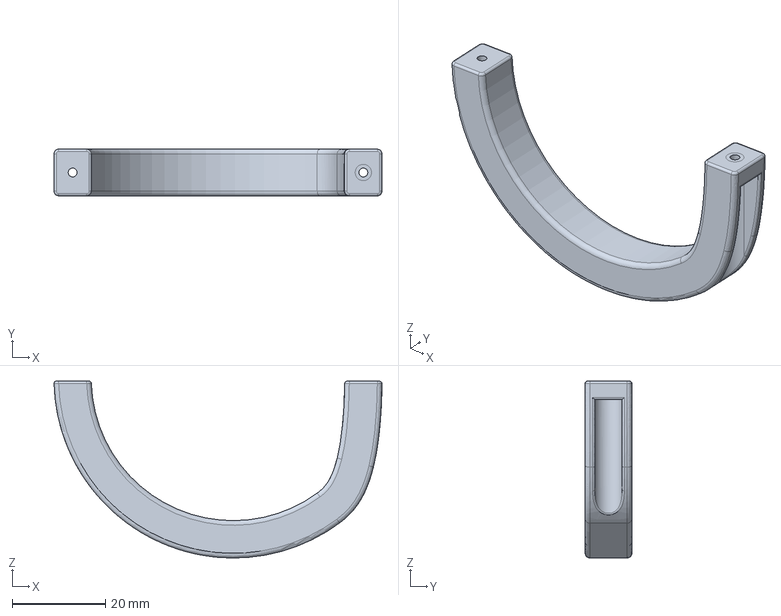
[picture p39: CAD file, 2025-02-12]
3D printed models/Imitation Learning/Wrist_camera_D435/Wrist_loop.step
70.2 x 10.0 x 37.9 mm
