Trap-1/HOMIE-Teleop-Hardware/3D printed models/Exoskeleton/Fourier_GR-1/ARM_LEFT/ARM_7.step

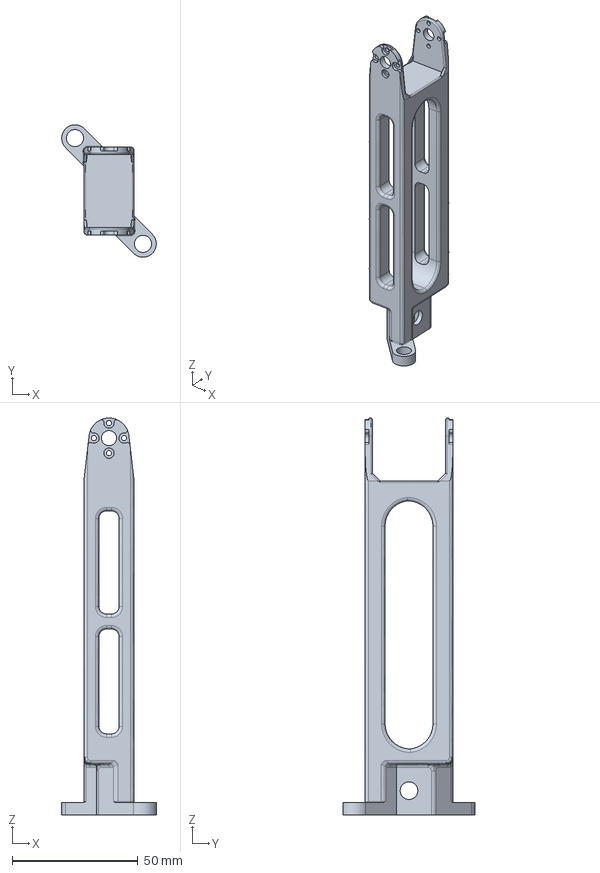
[picture p40: CAD file, 2025-02-11]
3D printed models/Exoskeleton/Fourier_GR-1/ARM_LEFT/ARM_7.step
37.7 x 52.7 x 158.0 mm
