Trap-1/HOMIE-Teleop-Hardware/3D printed models/Exoskeleton/Unitree_G1/ARM_LEFT/ARM_3.step

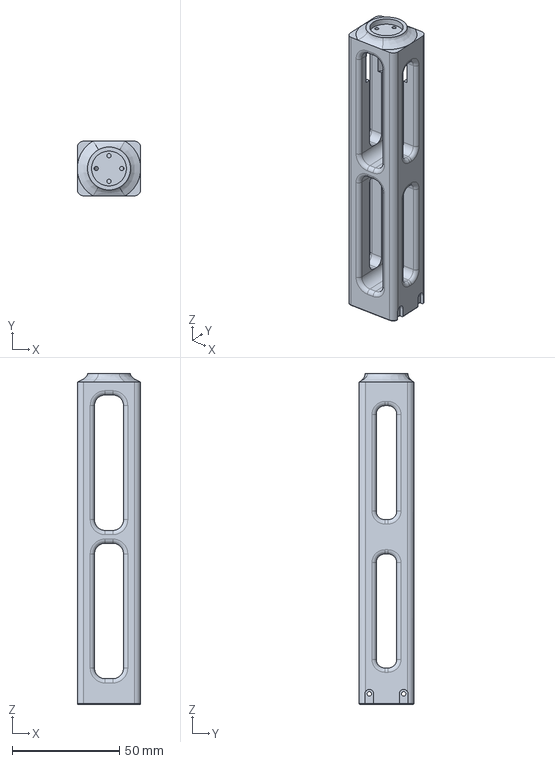
[picture p41: CAD file, 2025-02-11]
3D printed models/Exoskeleton/Unitree_G1/ARM_LEFT/ARM_3.step
29.5 x 25.5 x 154.0 mm
