Trap-1/HOMIE-Teleop-Hardware/3D printed models/Exoskeleton/Unitree_G1/BACK/BACK_1.step

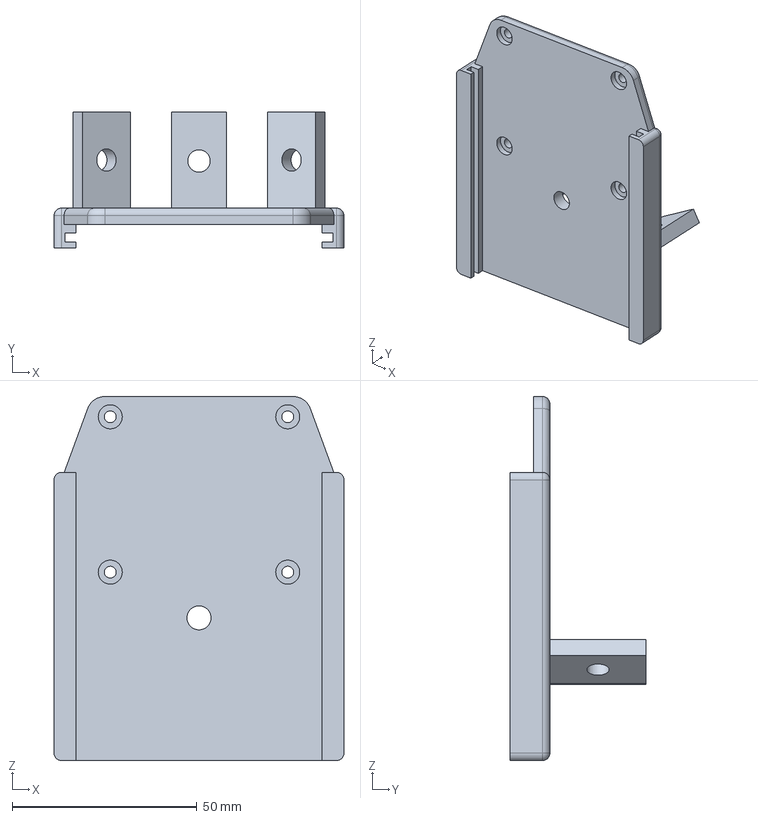
[picture p42: CAD file, 2025-02-11]
3D printed models/Exoskeleton/Unitree_G1/BACK/BACK_1.step
78.4 x 36.8 x 98.4 mm
