Trap-1/HOMIE-Teleop-Hardware/3D printed models/Foot Pedal/Small pedal/Small pedal_6.step

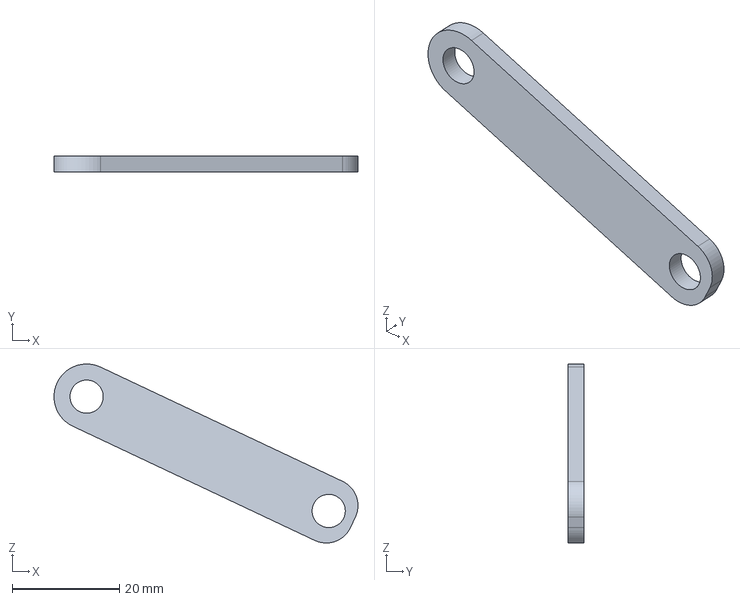
[picture p43: CAD file, 2025-02-11]
3D printed models/Foot Pedal/Small pedal/Small pedal_6.step
56.8 x 3.00 x 33.4 mm
