Trap-1/HOMIE-Teleop-Hardware/3D printed models/Foot Pedal/Switch pedal/Switch pedal_3.step

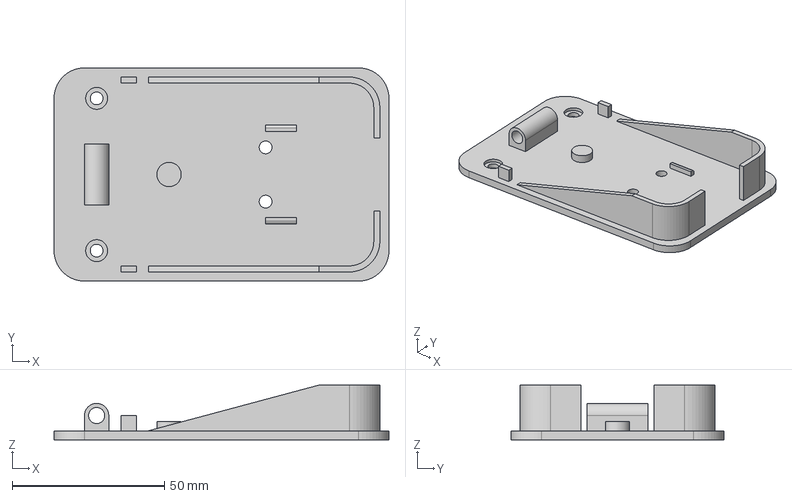
[picture p44: CAD file, 2025-02-11]
3D printed models/Foot Pedal/Switch pedal/Switch pedal_3.step
110.0 x 70.0 x 18.0 mm
