Trap-1/HOMIE-Teleop-Hardware/3D printed models/Exoskeleton/Fourier_GR-1/ARM_LEFT/ARM_4.step

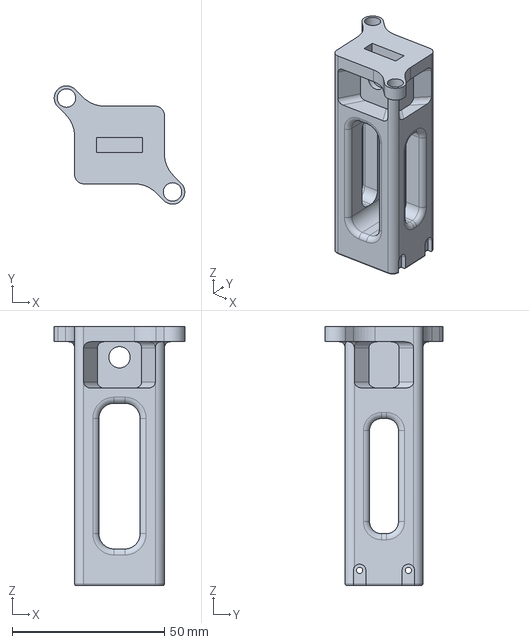
[picture p45: CAD file, 2025-02-11]
3D printed models/Exoskeleton/Fourier_GR-1/ARM_LEFT/ARM_4.step
42.9 x 38.9 x 85.0 mm
