Trap-1/HOMIE-Teleop-Hardware/3D printed models/Exoskeleton/Unitree_G1/ARM_RIGHT/ARM_6.step

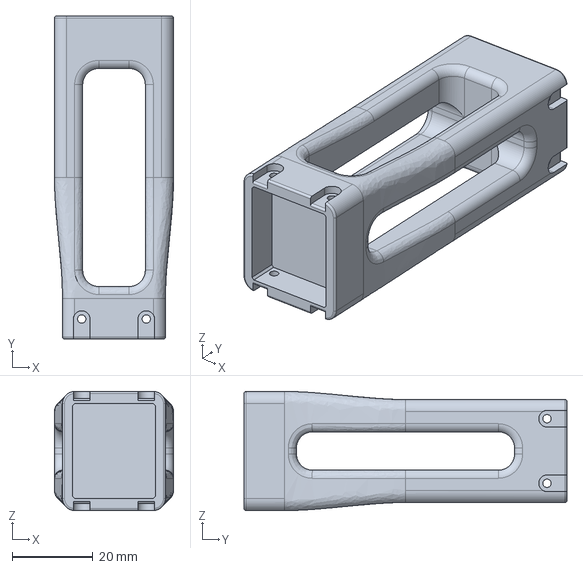
[picture p46: CAD file, 2025-02-11]
3D printed models/Exoskeleton/Unitree_G1/ARM_RIGHT/ARM_6.step
29.5 x 80.0 x 29.5 mm
