Trap-1/HOMIE-Teleop-Hardware/3D printed models/Exoskeleton/Fourier_GR-1/ARM_RIGHT/ARM_1.step

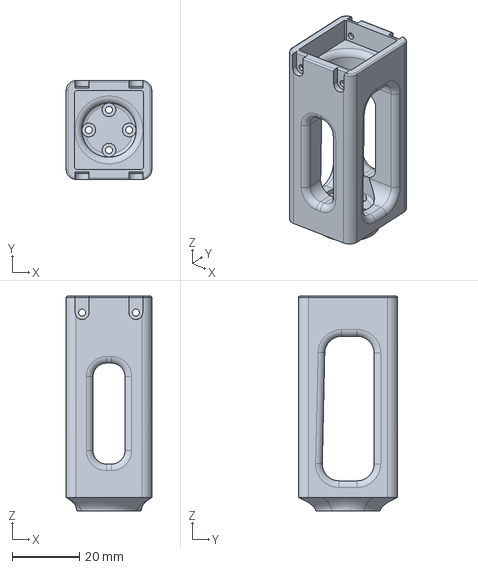
[picture p48: CAD file, 2025-02-11]
3D printed models/Exoskeleton/Fourier_GR-1/ARM_RIGHT/ARM_1.step
25.5 x 29.5 x 64.0 mm
