Trap-1/HOMIE-Teleop-Hardware/3D printed models/Foot Pedal/Small pedal/Small pedal_8.step

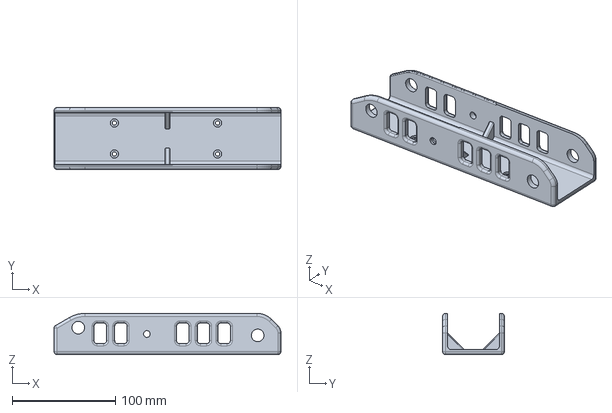
[picture p49: CAD file, 2025-02-11]
3D printed models/Foot Pedal/Small pedal/Small pedal_8.step
220.0 x 60.0 x 40.0 mm
