Trap-1/HOMIE-Teleop-Hardware/3D printed models/Exoskeleton/Fourier_GR-1/ARM_LEFT/ARM_3.step

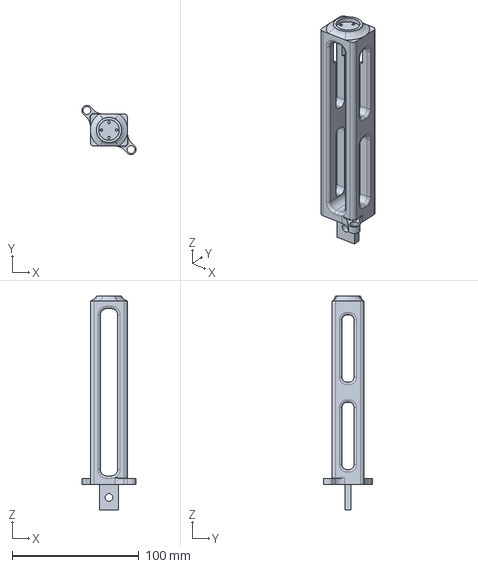
[picture p50: CAD file, 2025-02-11]
3D printed models/Exoskeleton/Fourier_GR-1/ARM_LEFT/ARM_3.step
42.9 x 38.9 x 169.0 mm
