Trap-1/HOMIE-Teleop-Hardware/(list of files, cad)

Other CAD files:
3D printed models/Exoskeleton/Unitree_G1/ARM_RIGHT/ARM_5.step
3D printed models/Gloves/Left glove/5 Pinky/Pinky_1.step
3D printed models/Exoskeleton/Fourier_GR-1/WRIST_LINK/WRIST_LINK_LEFT.step
3D printed models/Exoskeleton/Unitree_G1/WRIST_LINK/WRIST_LINK_RIGHT.step
3D printed models/Gloves/Left glove/1 Thumb/Thumb_1.step
3D printed models/Gloves/Left glove/6 Palm/Palm_1.step
3D printed models/Gloves/Right glove/2 Index finger/Index finger_1.step
3D printed models/Imitation Learning/Wrist_camera_D435/Left_Wrist_camera_D435.step
3D printed models/Exoskeleton/Fourier_GR-1/ARM_LEFT/ARM_2.step
3D printed models/Exoskeleton/Fourier_GR-1/ARM_RIGHT/ARM_6.step
3D printed models/Exoskeleton/Fourier_GR-1/BACK/BACK_3.step
3D printed models/Exoskeleton/Unitree_G1/ARM_LEFT/ARM_1.step
3D printed models/Exoskeleton/Unitree_G1/BACK/BACK_5(RIGHT).step
3D printed models/Gloves/Left glove/4 Ring finger/Ring finger_1.step
3D printed models/Gloves/Right glove/1 Thumb/Thumb_1.step
3D printed models/Exoskeleton/Fourier_GR-1/ARM_RIGHT/ARM_7.step
3D printed models/Exoskeleton/Fourier_GR-1/BACK/BACK_4(LEFT).step
3D printed models/Exoskeleton/Unitree_G1/ARM_RIGHT/ARM_3.step
3D printed models/Gloves/Right glove/3 Middle finger/Middle finger_1.step
3D printed models/Exoskeleton/Fourier_GR-1/ARM_RIGHT/ARM_5.step
3D printed models/Exoskeleton/Unitree_G1/ARM_LEFT/ARM_4.step
3D printed models/Gloves/Left glove/2 Index finger/Index finger_1.step
3D printed models/Gloves/Left glove/3 Middle finger/Middle finger_1.step
3D printed models/Exoskeleton/Fourier_GR-1/ARM_LEFT/ARM_8.step
3D printed models/Exoskeleton/Unitree_G1/ARM_LEFT/ARM_6.step
3D printed models/Exoskeleton/Unitree_G1/ARM_RIGHT/ARM_2.step
3D printed models/Gloves/Right glove/4 Ring finger/Ring finger_1.step
3D printed models/Gloves/Right glove/5 Pinky/Pinky_1.step
3D printed models/Exoskeleton/Fourier_GR-1/ARM_RIGHT/ARM_3.step
3D printed models/Exoskeleton/Fourier_GR-1/ARM_LEFT/ARM_1.step
3D printed models/Exoskeleton/Fourier_GR-1/ARM_RIGHT/ARM_4.step
