Trap-1/HOMIE-Teleop-Hardware/Micro controller/Sheet_Gloves.pdf

# Reset Power

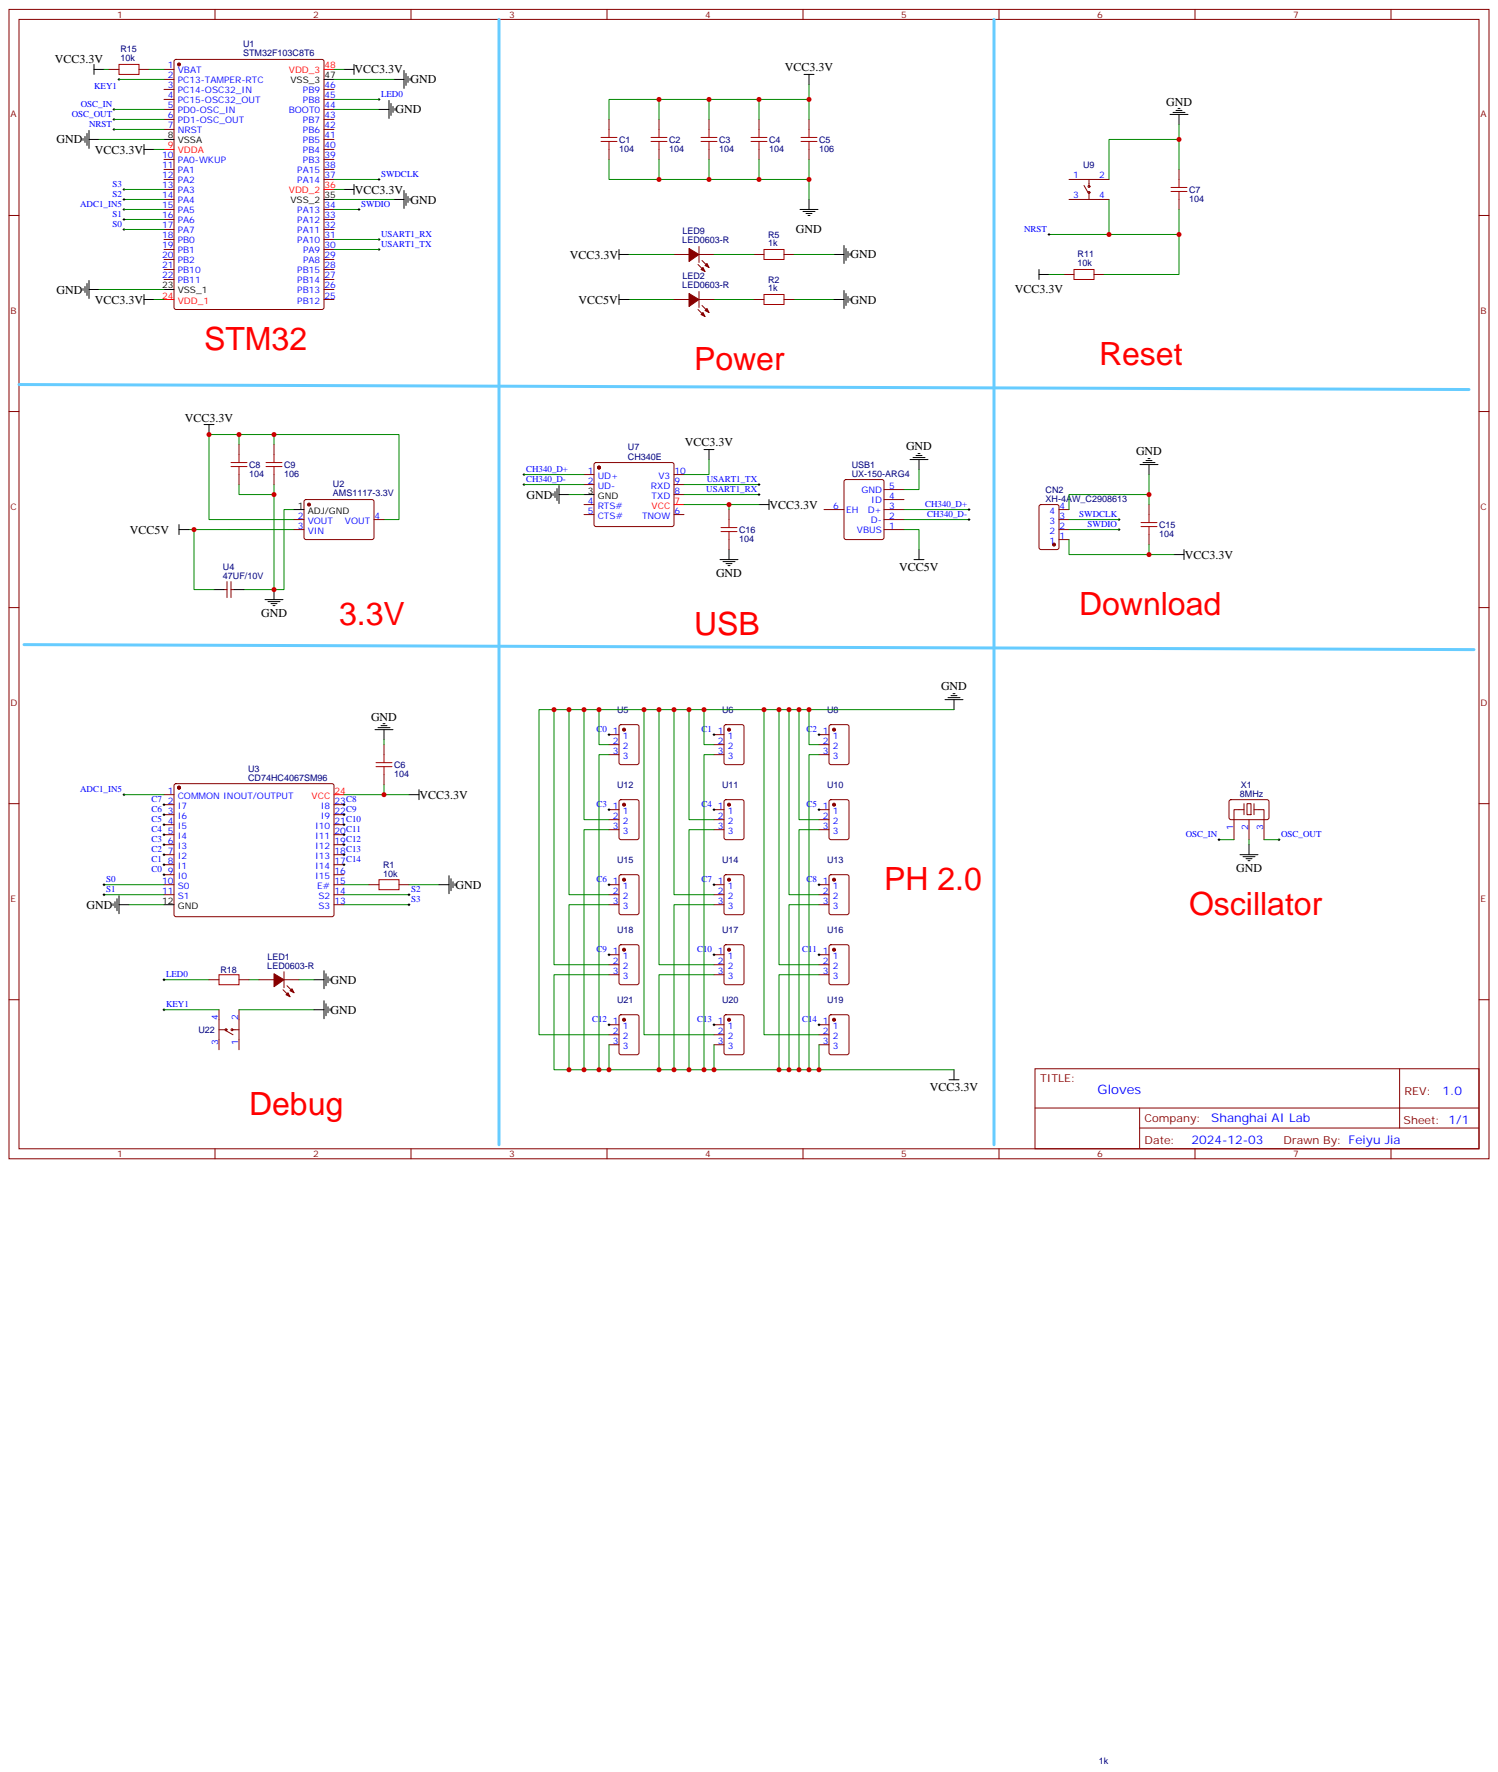
[picture p53: page 1]

Company: Shanghai AI Lab

Drawn By: Feiyu Jia
