Trap-1/HOMIE-Teleop-Hardware/Micro controller/Sheet_Pedal.pdf

# STM32

# Power

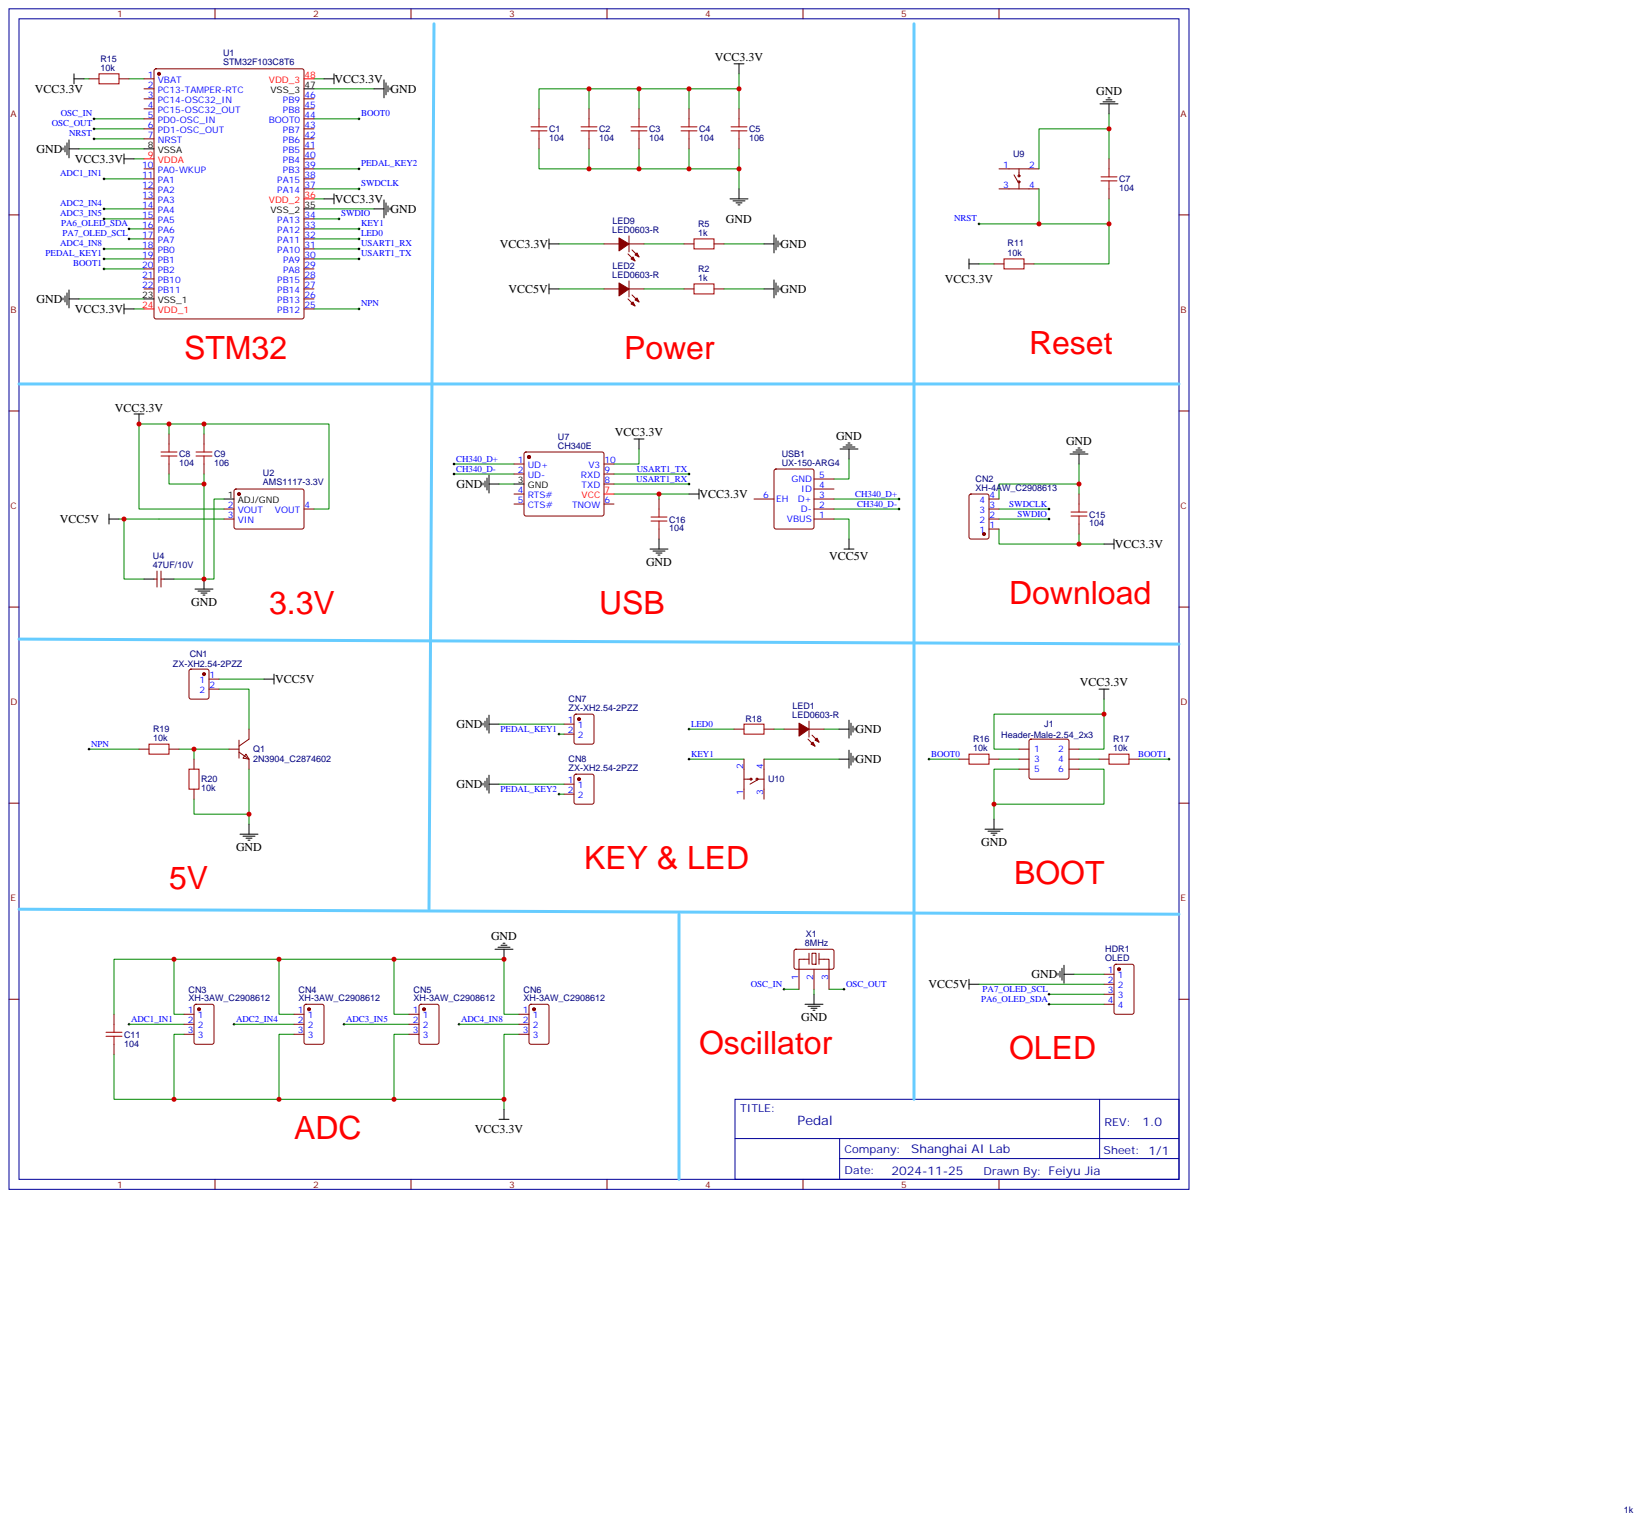
[picture p54: page 1]

Company: Shanghai AI Lab

Drawn By: Feiyu Jia
