Trap-1/HOMIE-Teleop-Hardware/Micro controller/Sheet_Hall sensor.pdf

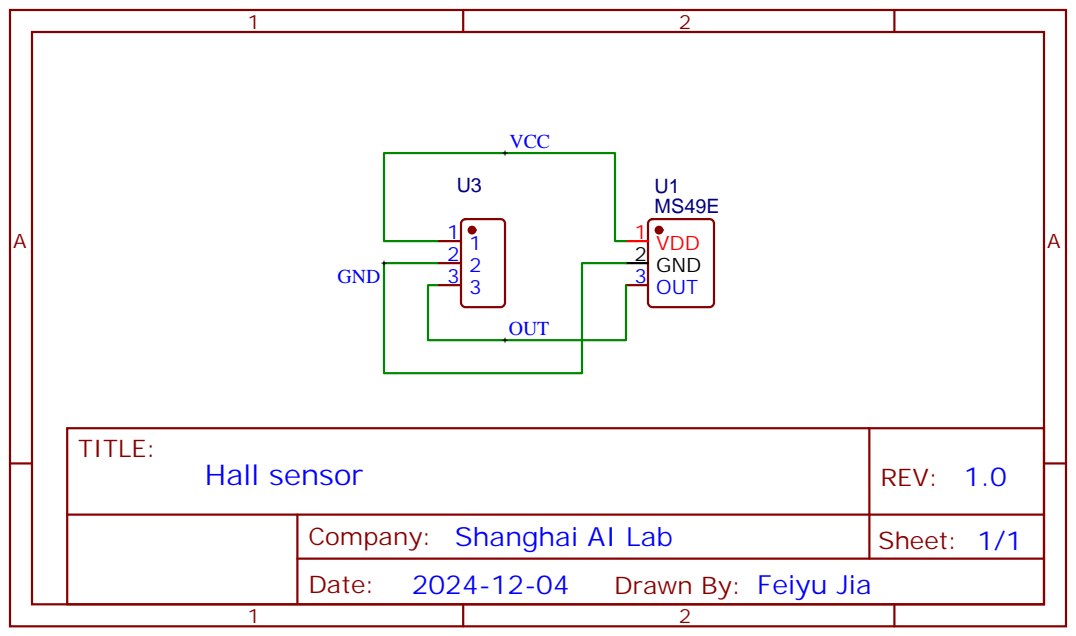
[picture p55: page 1]

Company: Shanghai AI Lab

Drawn By: Feiyu Jia
