Trap-1/HOMIE-Teleop-Hardware/(list of files, drawings)

Other design files:
Micro controller/Foot pedal/Altium Designer/PCB_Pedal.pcbdoc
Micro controller/Foot pedal/Altium Designer/Sheet_Pedal.schdoc
Micro controller/Foot pedal/EasyEDA/PCB_Pedal.json
Micro controller/Foot pedal/EasyEDA/SCH_Pedal.json
Micro controller/Gloves/Altium Designer/PCB_Gloves.pcbdoc
Micro controller/Gloves/Altium Designer/Sheet_Gloves.schdoc
Micro controller/Gloves/EasyEDA/PCB_Gloves.json
Micro controller/Gloves/EasyEDA/SCH_Gloves.json
Micro controller/Hall sensor module/Altium Designer/PCB_Hall-sensor.pcbdoc
Micro controller/Hall sensor module/Altium Designer/Sheet_Hall sensor.schdoc
Micro controller/Hall sensor module/EasyEDA/PCB_Hall-sensor.json
Micro controller/Hall sensor module/EasyEDA/SCH_Hall-sensor.json
