Trap-1/HOMIE-Teleop-Hardware/Keil code/Glove_keil_code/HARDWARE/TIMER/timer.c

#include "timer.h" 
#include "usart.h"
#include "stm32f10x_tim.h"
	 
void TIM3_Int_Init(u16 arr,u16 psc)
{	
	NVIC_InitTypeDef NVIC_InitStructure;
	TIM_TimeBaseInitTypeDef  TIM_TimeBaseStructure;

	RCC_APB1PeriphClockCmd(RCC_APB1Periph_TIM3, ENABLE);
	
	TIM_TimeBaseStructure.TIM_Period = arr; 
	TIM_TimeBaseStructure.TIM_Prescaler =psc; 
	TIM_TimeBaseStructure.TIM_ClockDivision = TIM_CKD_DIV1; 
	TIM_TimeBaseStructure.TIM_CounterMode = TIM_CounterMode_Up;  
	TIM_TimeBaseInit(TIM3, &TIM_TimeBaseStructure); 
 
	TIM_ITConfig(TIM3,TIM_IT_Update,ENABLE ); 
	
	TIM_Cmd(TIM3,ENABLE);
	
	NVIC_InitStructure.NVIC_IRQChannel = TIM3_IRQn;
	NVIC_InitStructure.NVIC_IRQChannelPreemptionPriority=0 ;
	NVIC_InitStructure.NVIC_IRQChannelSubPriority = 2;		
	NVIC_InitStructure.NVIC_IRQChannelCmd = ENABLE;			
	NVIC_Init(&NVIC_InitStructure);	
	
}

 
void TIM3_IRQHandler(void)
{ 	
	if (TIM_GetITStatus(TIM3, TIM_IT_Update) != RESET)
	{	 			   
		USART3_RX_STA|=1<<15;
		TIM_ClearITPendingBit(TIM3, TIM_IT_Update  );    
		TIM_Cmd(TIM3, DISABLE); 
	}	    
}
