Trap-1/HOMIE-Teleop-Hardware/Keil code/Foot_Pedal_keil_code/HARDWARE/LCD/lcd_init.h

#ifndef __LCD_INIT_H
#define __LCD_INIT_H

#include "sys.h"

#define USE_HORIZONTAL 1  //设置横屏或者竖屏显示 0或1为竖屏 2或3为横屏


#if USE_HORIZONTAL==0||USE_HORIZONTAL==1
#define LCD_W 128
#define LCD_H 128

#else
#define LCD_W 128
#define LCD_H 128
#endif



//-----------------LCD端口定义---------------- 

#define LCD_SCLK_Clr() GPIO_ResetBits(GPIOB,GPIO_Pin_4)//SCL=SCLK
#define LCD_SCLK_Set() GPIO_SetBits(GPIOB,GPIO_Pin_4)

#define LCD_MOSI_Clr() GPIO_ResetBits(GPIOB,GPIO_Pin_5)//SDA=MOSI
#define LCD_MOSI_Set() GPIO_SetBits(GPIOB,GPIO_Pin_5)

#define LCD_RES_Clr()  GPIO_ResetBits(GPIOB,GPIO_Pin_6)//RES
#define LCD_RES_Set()  GPIO_SetBits(GPIOB,GPIO_Pin_6)

#define LCD_DC_Clr()   GPIO_ResetBits(GPIOB,GPIO_Pin_7)//DC
#define LCD_DC_Set()   GPIO_SetBits(GPIOB,GPIO_Pin_7)
 		     
#define LCD_CS_Clr()   GPIO_ResetBits(GPIOB,GPIO_Pin_8)//CS
#define LCD_CS_Set()   GPIO_SetBits(GPIOB,GPIO_Pin_8)

#define LCD_BLK_Clr()  GPIO_ResetBits(GPIOB,GPIO_Pin_9)//BLK
#define LCD_BLK_Set()  GPIO_SetBits(GPIOB,GPIO_Pin_9)




void LCD_GPIO_Init(void);//初始化GPIO
void LCD_Writ_Bus(u8 dat);//模拟SPI时序
void LCD_WR_DATA8(u8 dat);//写入一个字节
void LCD_WR_DATA(u16 dat);//写入两个字节
void LCD_WR_REG(u8 dat);//写入一个指令
void LCD_Address_Set(u16 x1,u16 y1,u16 x2,u16 y2);//设置坐标函数
void LCD_Init(void);//LCD初始化
#endif
