Trap-1/HOMIE-Teleop-Hardware/(commit log)

2025-02-11 Add pedal models
    [Baseplate.step, Small pedal_1.step, Small pedal_2.step, Small pedal_3.step, Small pedal_4.step, Small pedal_5.step, Small pedal_6.step, Small pedal_7.step]
2025-02-12 Add Imitation Leraning models
    [Head_camera_D455.step, Left_Wrist_camera_D435.step, Right_Wrist_camera_D435.step, Wrist_loop.step]
2025-02-12 Modify schematic diagram
